lovshikvinnu/FieldSense/docs/images/pipeline_architecture.png

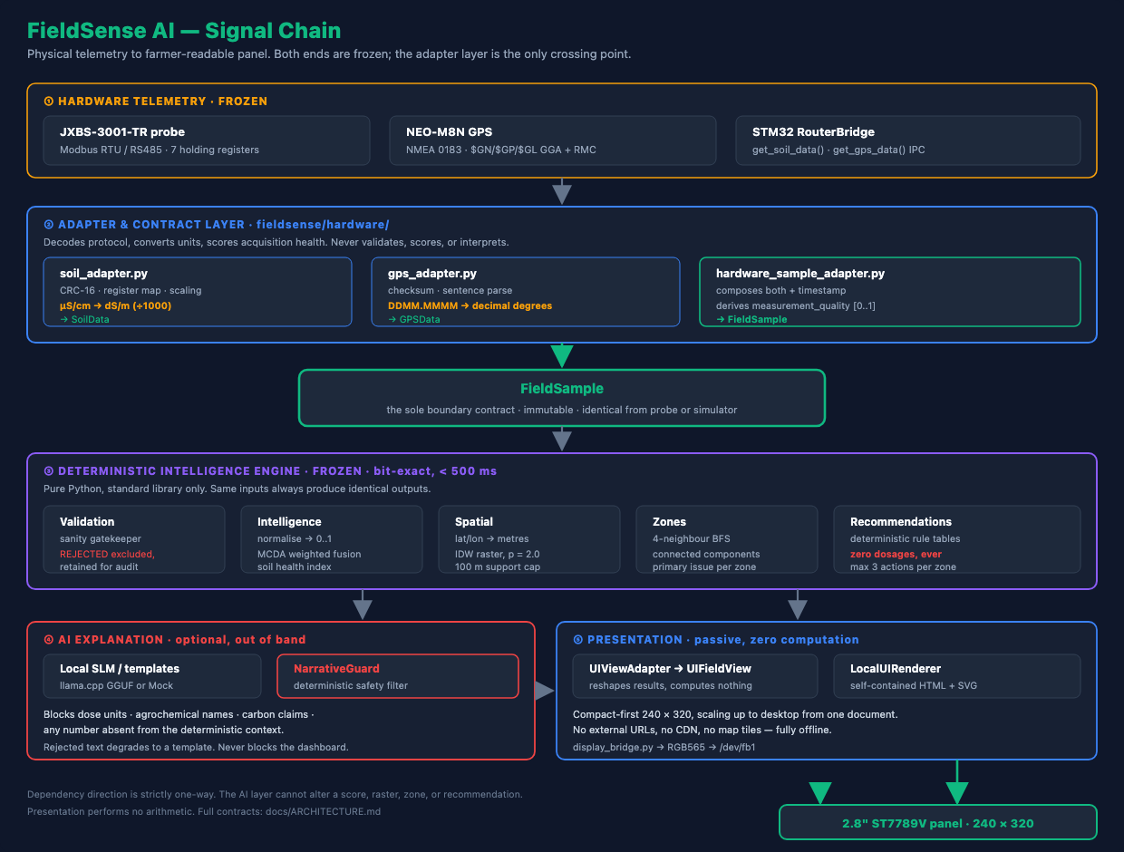
docs/images/pipeline_architecture.png
