lovshikvinnu/FieldSense/artifacts/field_test_map.html

FIELDSENSE AI

Offline Portable Edge-Intelligence Platform

OFFLINE MODE VIRTUAL

--%

MODERATE

●

Read More — AI Insights▸

Status & Diagnostics

Evidence LevelLIMITED

GPS Fix--

Sampling-- / --

Total Samples0

Valid0

Rejected0

Field Map

Tap a cell for details.

Management Zones

What Needs Attention

Plain Language Summary TEMPLATE ×
