lovshikvinnu/FieldSense/artifacts/field_test_panel.png

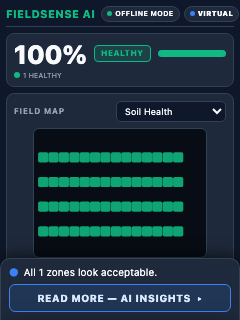
artifacts/field_test_panel.png
