lovshikvinnu/FieldSense/fieldsense/demo.py

"""FieldSense AI — Competition Demonstration Runner.

Executable via:
    python -m fieldsense.demo
"""

import os
from dataclasses import replace
from typing import Dict, Any

from fieldsense.testing.golden import GoldenDatasetRegistry
from fieldsense.intelligence import ValidationEngine, FieldIntelligenceEngine
from fieldsense.spatial import SpatialEngine, SpatialConfig
from fieldsense.zones import ZoneDetectionEngine
from fieldsense.recommendations import RecommendationEngine
from fieldsense.presentation import UIViewAdapter, LocalUIRenderer
from fieldsense.ai import AIAdapterFactory, build_explanation_context
from fieldsense.hardware.panel_renderer import write_panel_summary


def run_demo(
    output_path: str = "artifacts/fieldsense_competition_demo.html",
    scenario_name: str = "competition_demo_v1",
    enable_narrative: bool = True,
) -> Dict[str, Any]:
    """Execute complete 8-stage FieldSense pipeline demonstration and generate offline HTML dashboard.

    Args:
        output_path: Target path for HTML dashboard artifact output.
        scenario_name: Name of golden dataset scenario to load.
        enable_narrative: Attach an optional AI explanation narrative to the view.

    Returns:
        Dictionary containing demonstration summary metrics.
    """
    # 1. Load Competition Demonstration Golden Dataset
    scenario = GoldenDatasetRegistry.get_scenario(scenario_name)
    session = GoldenDatasetRegistry.load_session(scenario)
    total_samples = session.sample_count

    # 2. Validation Engine
    val_engine = ValidationEngine()
    eligible_samples = val_engine.get_session_eligible_samples(session)
    valid_samples = len(eligible_samples)
    rejected_samples = max(0, total_samples - valid_samples)

    # 3. Deterministic Intelligence Engine
    intel_engine = FieldIntelligenceEngine()
    intel_results = intel_engine.process_many(eligible_samples)

    # 4. Spatial Engine
    spatial_engine = SpatialEngine(config=SpatialConfig(grid_spacing_meters=10.0))
    spatial_result = spatial_engine.process(intel_results, eligible_samples)

    # 5. Zone Detection Engine
    zone_engine = ZoneDetectionEngine()
    zone_result = zone_engine.process(spatial_result)

    # 6. Recommendation Engine
    rec_engine = RecommendationEngine()
    rec_result = rec_engine.process(zone_result)

    # 7. UI View Adapter
    ui_adapter = UIViewAdapter()
    ui_view = ui_adapter.adapt(session, spatial_result, zone_result, rec_result)

    # 7b. Optional AI Explanation Layer.
    # Deliberately OUT OF BAND: it runs after the deterministic pipeline has
    # completed, never inside it. A real model backend costs tens of seconds on
    # edge hardware, far beyond the < 500 ms deterministic budget, so the
    # narrative must always be optional and always discardable.
    # The factory resolves to MockAIAdapter unless GGUF weights and a
    # llama.cpp binary are both present, so this upgrades automatically when a
    # model is installed and needs no code change.
    narrative = None
    if enable_narrative:
        ai_adapter = AIAdapterFactory.create_adapter()
        try:
            narrative = ai_adapter.explain(
                build_explanation_context(session, spatial_result, zone_result, rec_result)
            )
        finally:
            ai_adapter.shutdown()
        ui_view = replace(ui_view, narrative=narrative)

    # 8. Local HTML Renderer
    renderer = LocalUIRenderer()
    html_content = renderer.render_html(ui_view)

    # Ensure output directory exists
    os.makedirs(os.path.dirname(output_path), exist_ok=True)
    with open(output_path, "w", encoding="utf-8") as f:
        f.write(html_content)

    summary = {
        "dataset": scenario.name,
        "session_id": session.session_id,
        "total_samples": total_samples,
        "valid_samples": valid_samples,
        "rejected_samples": rejected_samples,
        "soil_health_score": ui_view.health_summary.score,
        "soil_health_status": ui_view.health_summary.status,
        "coverage_ratio": round(spatial_result.coverage.coverage_ratio * 100, 1),
        "zone_count": len(zone_result.zones),
        "recommendation_count": len(rec_result.recommendations),
        "output_path": output_path,
        "offline_mode": ui_view.system_status.offline_mode,
        "data_source": ui_view.system_status.data_source,
        "narrative_source": narrative.generated_by if narrative else "DISABLED",
        "narrative_status": narrative.generation_status.value if narrative else "DISABLED",
        "narrative_violations_blocked": len(narrative.guard_violations) if narrative else 0,
        "evidence_level": ui_view.health_summary.evidence_level,
        "field_name": ui_view.field.field_name,
        "soil_health_percent": round(ui_view.health_summary.score * 100.0),
        "provenance": "GOLDEN_DATASET",
    }

    # Panel summary for the browser-free display path. The 2.8" panel needs a
    # renderer that works with no Chromium installed, and that renderer reads
    # these numbers rather than recomputing them, so the panel can never
    # disagree with the dashboard. Failure to write it is non-fatal.
    # Beside the dashboard it describes, not at the module default. Writing to
    # the fixed artifacts/ path regardless of output_path meant any caller that
    # redirected the HTML - every test does - still rewrote the committed
    # summary, dirtying a tracked file nobody edited.
    summary["panel_summary_path"] = write_panel_summary(
        summary,
        os.path.join(os.path.dirname(output_path) or ".", "panel_summary.json"),
    )

    # Print clean terminal report
    print("\n==================================================")
    print("           FIELDSENSE AI — DEMO                   ")
    print("==================================================")
    print(f"Dataset:            {summary['dataset']}")
    print(f"Data Source:        {summary['data_source']} (Offline Mode: {summary['offline_mode']})")
    print(f"Samples:            {summary['total_samples']} Total | {summary['valid_samples']} Valid | {summary['rejected_samples']} Rejected")
    print(f"Overall Health:     {int(summary['soil_health_score'] * 100)}% [{summary['soil_health_status']}]")
    print(f"Coverage Ratio:     {summary['coverage_ratio']}%")
    print(f"Zones Detected:     {summary['zone_count']} Spatially Connected Management Zones")
    print(f"Recommendations:    {summary['recommendation_count']} Rule-Based Actions")
    print(f"Explanation Layer:  {summary['narrative_source']} [{summary['narrative_status']}] | Guard Blocks: {summary['narrative_violations_blocked']}")
    print(f"Dashboard Artifact: {summary['output_path']}")
    print("==================================================\n")

    return summary


if __name__ == "__main__":
    run_demo()
