lovshikvinnu/FieldSense/tests/test_landscape_panel.py

"""Hold the panel firmware to the landscape layout it claims.

The far side of this layout is firmware. A coordinate that runs off the bottom
of the screen, or an instruction string too long for the width it is drawn in,
is invisible until someone flashes a board and looks at it — and on the UNO Q a
flash-and-look cycle is about ninety seconds. These tests read the .ino files as
text so a clipped layout fails here instead.

Nothing is compiled or flashed. The sketches are parsed as source.
"""

import os
import re

import pytest

from fieldsense.field.panel import (
    ACTION_LINES,
    BUTTON_LABELS,
    RETRY_BUTTON_LABEL,
    RETRY_TEASER,
    TEASER_LINES,
)

REPO_ROOT = os.path.dirname(os.path.dirname(os.path.abspath(__file__)))
DEPLOYED = os.path.join(REPO_ROOT, "firmware", "fieldsense_unoq", "fieldsense_unoq.ino")
DISPLAY_ONLY = os.path.join(REPO_ROOT, "hardware", "tft-unoq", "dashboard", "dashboard.ino")
SKETCHES = (DEPLOYED, DISPLAY_ONLY)

# Adafruit_GFX's built-in font, which both sketches use.
CHAR_W = 6
CHAR_H = 8

# Must match the sketches' MARGIN and ACTION_H.
MARGIN = 6
ACTION_BOX_W = 320 - 2 * MARGIN
DRAW_CENTERED_PADDING = 8      # drawCentered() reserves this inside the box


def _read(path):
    if not os.path.exists(path):
        pytest.skip("sketch not present: {}".format(path))
    return open(path, encoding="utf-8", errors="replace").read()


#: Constants the layout expressions are allowed to reference. Resolved first so
#: a definition like `SOIL_COL_A = MARGIN + 8` can be evaluated here exactly as
#: the compiler would, rather than forcing every constant in the sketch to be a
#: bare literal purely so a test can read it.
_BASE_CONSTS = ("PANEL_W", "PANEL_H", "MARGIN")


def _const(source, name, _seen=None):
    """Read one layout constant, resolving simple arithmetic on other constants."""
    match = re.search(
        r"\b{}\s*=\s*([-+*/ 0-9A-Z_a-z]+?)\s*[;,]".format(re.escape(name)), source)
    assert match, "layout constant {} not found".format(name)
    expression = match.group(1).strip()

    seen = set(_seen or ())
    assert name not in seen, "circular layout constant: {}".format(name)
    seen.add(name)

    scope = {}
    for base in _BASE_CONSTS:
        if base != name and re.search(r"\b{}\b".format(base), expression):
            scope[base] = _const(source, base, seen)
    try:
        return int(eval(expression, {"__builtins__": {}}, scope))  # noqa: S307
    except Exception as exc:  # pragma: no cover - a malformed sketch constant
        raise AssertionError(
            "could not evaluate {} = {!r}: {}".format(name, expression, exc))


def _fit_size(text, width, max_size):
    """Mirror of the sketch's fitTextSize(): largest size that fits, floor 1."""
    if not text:
        return max_size
    for size in range(max_size, 1, -1):
        if len(text) * CHAR_W * size <= width:
            return size
    return 1


# ------------------------------------------------------- orientation


@pytest.mark.parametrize("path", SKETCHES)
def test_the_panel_boots_directly_into_landscape(path):
    """Not rotated later, not left to the host: landscape from setup().

    ST7789 rotations 1 and 3 are the same landscape surface 180 degrees apart -
    both report 320x240, so every coordinate in the sketch maps unchanged and
    either is a valid orientation for this unit. 0 and 2 are portrait and would
    invalidate the whole layout, which is what this actually guards.
    """
    source = _read(path)
    assert _const(source, "PANEL_ROTATION") in (1, 3), \
        "rotation must be landscape (1 or 3), not portrait"
    assert re.search(r"tft\.setRotation\(\s*PANEL_ROTATION\s*\)", source), \
        "setRotation must use PANEL_ROTATION so the constant cannot drift from the call"


@pytest.mark.parametrize("path", SKETCHES)
def test_the_background_is_black(path):
    """Every cleared region uses COL_BG, so this one constant is the background.

    It was a deep slate borrowed from the HTML dashboard - nearly black on a
    monitor, visibly grey on this panel in daylight, and every clear read as a
    grey flash rather than as background.
    """
    source = _read(path)
    match = re.search(r"\bCOL_BG\s*=\s*0x([0-9A-Fa-f]{4})", source)
    assert match, "COL_BG not found"
    assert int(match.group(1), 16) == 0x0000, \
        "COL_BG is 0x{}, not black".format(match.group(1))


@pytest.mark.parametrize("path", SKETCHES)
def test_no_full_screen_clear_outside_setup(path):
    """fillScreen on a periodic repaint is a visible wipe - there is no
    framebuffer between this sketch and the glass."""
    source = _read(path)
    body = source[source.index("static void renderValues"):]
    assert "fillScreen" not in body, \
        "renderValues (or something after it) clears the whole screen"


@pytest.mark.parametrize("path", SKETCHES)
def test_dynamic_regions_repaint_only_when_they_change(path):
    """The flicker fix. renderValues runs once a second so the age counter stays
    truthful, and almost nothing else on the panel changes in that second."""
    source = _read(path)
    assert "changedSince" in source, "the repaint-on-change guard is missing"
    body = source[source.index("static void renderValues"):]
    assert body.count("changedSince") >= 4, \
        "only {} dynamic regions are gated".format(body.count("changedSince"))


@pytest.mark.parametrize("path", SKETCHES)
def test_card_backgrounds_are_chrome_not_values(path):
    """Painting the card background every second is what wiped the card."""
    source = _read(path)
    assert "renderSoilChrome" in source and "renderResultChrome" in source, \
        "card background and labels should be separate from the value path"
    values = source[source.index("static void renderSoilCard"):
                    source.index("static void renderResultChrome")]
    assert "fillRoundRect" not in values, \
        "renderSoilCard still repaints its own card background"


@pytest.mark.parametrize("path", SKETCHES)
def test_the_drawing_surface_is_320_by_240(path):
    source = _read(path)
    assert _const(source, "PANEL_W") == 320
    assert _const(source, "PANEL_H") == 240


@pytest.mark.parametrize("path", SKETCHES)
def test_init_is_given_the_native_geometry_not_the_rotated_one(path):
    """init() takes the glass's real 240x320; setRotation does the rest.

    Passing the rotated size here is the classic version of this bug: the
    driver sets its address window from these numbers, so a 320x240 init
    produces a display that scrolls or wraps rather than one that is landscape.
    """
    source = _read(path)
    assert re.search(r"tft\.init\(\s*240\s*,\s*320\s*\)", source), \
        "tft.init() must be given the native 240x320 panel geometry"


@pytest.mark.parametrize("path", SKETCHES)
def test_no_portrait_geometry_survives_in_the_layout(path):
    """A leftover 240-wide assumption would hug everything to the left third."""
    source = _read(path)
    for name in ("HEADER_Y", "GPS_Y", "ACTION_Y", "SOIL_Y", "BAR_Y"):
        assert _const(source, name) < 240, \
            "{} is below a 240-tall landscape screen".format(name)


# ----------------------------------------------------------- fit


@pytest.mark.parametrize("path", SKETCHES)
def test_every_band_fits_inside_the_screen(path):
    """Bands must tile the height without running off the bottom edge."""
    source = _read(path)
    height = _const(source, "PANEL_H")
    bands = [
        (_const(source, "HEADER_Y"), _const(source, "HEADER_H")),
        (_const(source, "GPS_Y"), _const(source, "GPS_H")),
        (_const(source, "ACTION_Y"), _const(source, "ACTION_H")),
        (_const(source, "SOIL_Y"), _const(source, "SOIL_H")),
        (_const(source, "BAR_Y"), _const(source, "BAR_H")),
    ]
    for top, band_height in bands:
        assert top + band_height <= height, \
            "band at y={} height={} overruns the {}px screen".format(top, band_height, height)


@pytest.mark.parametrize("path", SKETCHES)
def test_the_bands_do_not_overlap(path):
    """Overlapping bands are how two values end up drawn on top of each other."""
    source = _read(path)
    bands = sorted([
        (_const(source, "HEADER_Y"), _const(source, "HEADER_H")),
        (_const(source, "GPS_Y"), _const(source, "GPS_H")),
        (_const(source, "ACTION_Y"), _const(source, "ACTION_H")),
        (_const(source, "SOIL_Y"), _const(source, "SOIL_H")),
        (_const(source, "BAR_Y"), _const(source, "BAR_H")),
    ])
    for (top, height), (next_top, _) in zip(bands, bands[1:]):
        assert top + height <= next_top, \
            "band at y={} (h={}) overlaps the band at y={}".format(top, height, next_top)


@pytest.mark.parametrize("path", SKETCHES)
def test_the_soil_columns_use_the_full_width(path):
    """Two columns are the whole reason for landscape; one column wastes it."""
    source = _read(path)
    col_a = _const(source, "SOIL_COL_A")
    assert col_a < 160, "the first soil column should start in the left half"
    assert re.search(r"SOIL_COL_B\s*=\s*PANEL_W\s*/\s*2", source), \
        "the second soil column should be derived from the panel width"


@pytest.mark.parametrize("path", SKETCHES)
def test_the_soil_rows_fit_inside_their_card(path):
    source = _read(path)
    row_h = _const(source, "SOIL_ROW_H")
    # Four label/value rows are drawn, the first at +6 from the card top.
    assert 6 + row_h * 3 + CHAR_H <= _const(source, "SOIL_H"), \
        "four soil rows do not fit inside SOIL_H"


# ------------------------------------------------ operator instructions


def test_every_operator_instruction_fits_the_landscape_width():
    """The host must not be able to send an instruction the panel would clip.

    drawCentered() truncates rather than overflowing, so a too-long string
    would not corrupt the layout - it would silently drop the end of the
    sentence, which on an instruction line is worse.
    """
    width = ACTION_BOX_W - DRAW_CENTERED_PADDING
    for state, template in ACTION_LINES.items():
        text = template.format(i=8, m=8)
        size = _fit_size(text, width, 3)
        assert len(text) * CHAR_W * size <= width, \
            "{}: {!r} clips even at text size 1".format(state.value, text)


def test_the_instructions_stay_large_enough_to_read_at_arms_length():
    """Every instruction should reach at least size 2, i.e. 16px tall glyphs."""
    width = ACTION_BOX_W - DRAW_CENTERED_PADDING
    for state, template in ACTION_LINES.items():
        text = template.format(i=8, m=8)
        assert _fit_size(text, width, 3) >= 2, \
            "{}: {!r} is too long to render above text size 1".format(state.value, text)


def test_the_headline_saved_message_gets_the_largest_size():
    """SAMPLE N SAVED is the confirmation an operator looks for from a distance."""
    text = ACTION_LINES[list(ACTION_LINES)[3]].format(i=1, m=5)
    assert _fit_size(text, ACTION_BOX_W - DRAW_CENTERED_PADDING, 3) == 3


# ------------------------------------------------------- both sketches


def test_both_sketches_share_the_same_layout_constants():
    """The bench panel and the field panel must not drift into two layouts."""
    deployed, display = _read(DEPLOYED), _read(DISPLAY_ONLY)
    for name in ("PANEL_W", "PANEL_H", "PANEL_ROTATION", "HEADER_Y", "HEADER_H",
                 "GPS_Y", "GPS_H", "ACTION_Y", "ACTION_H", "SOIL_Y", "SOIL_H",
                 "BAR_Y", "BAR_H", "MARGIN", "SOIL_ROW_H"):
        assert _const(deployed, name) == _const(display, name), \
            "{} differs between the two sketches".format(name)


def test_the_repo_layout_constants_match_the_ones_these_tests_assume():
    """Guard the constants this file hard-codes against a silent sketch edit."""
    source = _read(DEPLOYED)
    assert _const(source, "MARGIN") == MARGIN
    assert _const(source, "CHAR_W") == CHAR_W
    assert _const(source, "CHAR_H") == CHAR_H
    assert _const(source, "ACTION_H") >= CHAR_H * 3, \
        "the action band must be tall enough for size-3 text"


# ------------------------------------------------ visual-first UI elements


def _every_teaser():
    """Every guidance line the panel can display, expanded."""
    lines = [t.format(i=8, m=8) for t in TEASER_LINES.values()]
    lines.append(RETRY_TEASER.format(i=8, m=8))
    return lines


def _every_button():
    labels = [b for b in BUTTON_LABELS.values() if b]
    labels.append(RETRY_BUTTON_LABEL)
    return labels


def test_every_teaser_is_readable_at_arms_length():
    """Size 1 is 8 px tall and unreadable outdoors.

    'PROBE LOOSE - RE-SEAT IN SOIL' fitted only at size 1 - and it is the line
    an operator most needs to read without stopping to squint.
    """
    width = ACTION_BOX_W - DRAW_CENTERED_PADDING
    for text in _every_teaser():
        assert _fit_size(text, width, 3) >= 2, \
            "{!r} only renders at text size 1".format(text)


def test_every_button_label_renders_at_the_largest_size():
    """The single control has a whole bar to itself; it should use it."""
    width = ACTION_BOX_W - DRAW_CENTERED_PADDING
    for text in _every_button():
        assert _fit_size(text, width, 3) == 3, \
            "{!r} does not fit the action bar at size 3".format(text)


def test_teasers_are_one_line_and_short():
    """A 'teaser banner' that wraps is a paragraph again."""
    for text in _every_teaser():
        assert "\n" not in text
        assert len(text) <= 30, "{!r} is {} chars".format(text, len(text))


@pytest.mark.parametrize("path", SKETCHES)
def test_the_progress_strip_has_its_own_band(path):
    """The step bar must not share space with the header or the GPS line."""
    source = _read(path)
    prog_y, prog_h = _const(source, "PROG_Y"), _const(source, "PROG_H")
    assert prog_y >= _const(source, "HEADER_Y") + _const(source, "HEADER_H")
    assert prog_y + prog_h <= _const(source, "GPS_Y")


@pytest.mark.parametrize("path", SKETCHES)
def test_the_traffic_light_palette_is_the_specified_one(path):
    """Pure 0x07E0/0xF800 are driver primaries, not the product's colours."""
    source = _read(path)
    for name, value in (("COL_GOOD", 0x072E), ("COL_WARN", 0xFCC0),
                        ("COL_BAD", 0xFA8A)):
        match = re.search(r"\b{}\s*=\s*0x([0-9A-Fa-f]{{4}})".format(name), source)
        assert match, "{} not found".format(name)
        assert int(match.group(1), 16) == value, \
            "{} is 0x{} not 0x{:04X}".format(name, match.group(1), value)


@pytest.mark.parametrize("path", SKETCHES)
def test_the_panel_draws_a_tile_per_sample_and_per_zone(path):
    """Both grids read their length from the host string, not a fixed 5."""
    source = _read(path)
    assert "strlen(progressSegments)" in source, \
        "the progress strip should size itself from the host's string"
    assert "strlen(zoneStatuses)" in source, \
        "the zone map should size itself from the host's string"


def test_the_panel_rotation_matches_the_orientation_the_unit_was_read_in():
    """Rotation 3, established by holding the unit while it ran a rotation-3 sketch.

    An earlier version of this test asserted 1, on the argument that the board
    "ran the rotation-1 sketch continuously" and was upright. It did not: App
    Lab flashes its own copy of the sketch, and that copy was 209ae8a, which
    sets 3. The upright panel somebody looked at was a rotation-3 panel, so
    asserting 1 pinned the display upside down.

    Both values are landscape and the layout is identical either way, which is
    why this is worth pinning at all - nothing else in either sketch, and no
    other test, can tell the difference. It is also why a wrong value here
    survives every check except a human looking at the glass, so change it only
    on that evidence and say whose eyes.
    """
    assert _const(_read(DEPLOYED), "PANEL_ROTATION") == 3,         "the unit reads upright at rotation 3; 1 is the same surface upside down"
