lovshikvinnu/FieldSense/tests/test_field_node.py

"""The field node: triggers, one whole session, and the export it hands the pipeline.

The node is the only place hardware appears, so these tests substitute fakes for
the probe and the receiver and exercise everything else for real — the state
machine, the plausibility layer, the durable store, and the dataset written for
`run_spatial_test`. No board, no probe, no network.
"""

import json
import os
import threading
from datetime import datetime, timezone

import pytest

from fieldsense.domain.models import FieldSample
from fieldsense.domain.models.enums import SampleSource
from fieldsense.field.states import FieldState
from fieldsense.field_node import AutoTrigger, EnterTrigger, FieldNode, MCUTrigger
from fieldsense.hardware.gps.bridge_gps import UIEvent, parse_ui_event


# ------------------------------------------------------------- fakes


class FakeGPS:
    """Serves canned telemetry lines, the way the App Lab gateway would."""

    def __init__(self, lines):
        self.lines = list(lines)
        self.reads = 0

    def read_raw(self):
        self.reads += 1
        index = min(self.reads - 1, len(self.lines) - 1)
        return self.lines[index]


class FakeAdapter:
    """A probe and receiver that produce exactly the readings a test asks for."""

    def __init__(self, readings, gps_lines=None):
        self.readings = list(readings)
        self.index = 0
        self.initialized = False
        self.shutdown_called = False
        self.gps_adapter = FakeGPS(gps_lines or ["NO_FIX,0.0,0.0,Sats:0,HDOP:99.9,UI:0,TP:1,TZ:0"])
        self.last_acquisition_meta = {}

    def initialize(self):
        self.initialized = True

    def shutdown(self):
        self.shutdown_called = True

    def acquire_sample(self):
        reading = self.readings[min(self.index, len(self.readings) - 1)]
        self.index += 1
        self.last_acquisition_meta = {
            "gps_fix_valid": reading.get("fix_valid", True),
            "gps_quality": {"satellites": reading.get("satellites", 10),
                            "hdop": reading.get("hdop", 0.96)},
            "sensor_meta": {},
            "measurement_quality": reading.get("quality", 0.95),
        }
        return FieldSample(
            sample_id="HW-SMP-{:03d}".format(self.index),
            timestamp=datetime.now(timezone.utc),
            latitude=reading.get("lat", 17.5697),
            longitude=reading.get("lon", 78.4247),
            nitrogen=reading.get("nitrogen", 48.0),
            phosphorus=reading.get("phosphorus", 22.0),
            potassium=reading.get("potassium", 133.0),
            ph=reading.get("ph", 6.6),
            ec=reading.get("ec", 0.42),
            moisture=reading.get("moisture", 31.2),
            temperature=reading.get("temperature", 26.4),
            measurement_quality=reading.get("quality", 0.95),
            source=SampleSource.HARDWARE,
        )


def build_node(tmp_path, adapter, samples=3, **kwargs):
    """A node wired to `adapter`, writing everything under tmp_path."""
    node = FieldNode(
        planned_samples=samples,
        trigger="auto",
        panel_endpoint=None,
        session_root=str(tmp_path / "sessions"),
        output_dir=str(tmp_path / "artifacts"),
        dataset_path=str(tmp_path / "dataset.json"),
        settle_seconds=0.0,
        dwell_seconds=0.0,
        auto_delay=0.0,
        **kwargs,
    )
    node.adapter = adapter
    node.open_hardware = lambda: adapter.initialize()
    node.show = lambda extra=None: None          # no panel in a unit test
    # No background narrative either: it would re-run the whole pipeline in a
    # daemon thread and outlive the tmp_path it writes into. The tests that
    # care about it call FieldNode.start_narrative directly.
    node.start_narrative = lambda dataset: None
    return node


# ----------------------------------------------------------- triggers


def test_the_mcu_trigger_fires_on_a_counter_that_moved():
    gps = FakeGPS([
        "FIX_OK,1734.18N,07825.47E,Sats:10,HDOP:0.96,UI:4,TP:1,TZ:0",
        "FIX_OK,1734.18N,07825.47E,Sats:10,HDOP:0.96,UI:5,TP:1,TZ:1900",
    ])
    trigger = MCUTrigger(gps.read_raw, poll_seconds=0.0)
    trigger.sync()
    assert trigger.wait_for_press(timeout=2.0)


def test_the_mcu_trigger_ignores_a_counter_that_has_not_moved():
    gps = FakeGPS(["FIX_OK,1734.18N,07825.47E,Sats:10,HDOP:0.96,UI:4,TP:1,TZ:0"])
    trigger = MCUTrigger(gps.read_raw, poll_seconds=0.0)
    trigger.sync()
    assert not trigger.wait_for_press(timeout=0.2)


def test_syncing_adopts_a_press_that_happened_before_the_session_started():
    """Otherwise a press during boot fires sample 1 the instant the node arms."""
    gps = FakeGPS(["FIX_OK,1734.18N,07825.47E,Sats:10,HDOP:0.96,UI:7,TP:1,TZ:0"])
    trigger = MCUTrigger(gps.read_raw, poll_seconds=0.0)
    trigger.sync()
    assert trigger.last_count == 7
    assert not trigger.wait_for_press(timeout=0.2)


def test_an_mcu_reset_does_not_fire_a_burst_of_triggers():
    """A reflash restarts the counter at zero. That is not thirty presses."""
    gps = FakeGPS([
        "FIX_OK,1734.18N,07825.47E,Sats:10,HDOP:0.96,UI:30,TP:1,TZ:0",
        "FIX_OK,1734.18N,07825.47E,Sats:10,HDOP:0.96,UI:0,TP:1,TZ:0",
    ])
    trigger = MCUTrigger(gps.read_raw, poll_seconds=0.0)
    trigger.sync()
    assert not trigger.wait_for_press(timeout=0.2)
    assert trigger.last_count == 0


def test_firmware_without_the_control_is_distinguishable_from_no_press():
    old = parse_ui_event("FIX_OK,1734.18N,07825.47E,Sats:10,HDOP:0.96")
    assert not old.reported
    assert UIEvent(press_count=0).reported


def test_the_trigger_reports_a_panel_that_has_not_been_touched():
    gps = FakeGPS(["FIX_OK,1734.18N,07825.47E,Sats:10,HDOP:0.96,UI:0,TP:0,SA:0,TZ:0"])
    trigger = MCUTrigger(gps.read_raw, poll_seconds=0.0)
    trigger.sync()
    assert "no touch detected yet" in trigger.describe()


def test_the_trigger_distinguishes_pen_detect_from_working_coordinates():
    """The assembled unit pen-detects but its controller is silent over SPI.

    Conflating those two facts is what previously made the boot log claim touch
    was absent while it was in fact driving the workflow.
    """
    pen_only = FakeGPS(["FIX_OK,1734.18N,07825.47E,Sats:10,HDOP:0.96,UI:3,TP:1,SA:0,TZ:0"])
    trigger = MCUTrigger(pen_only.read_raw, poll_seconds=0.0)
    trigger.sync()
    assert "PEN-DETECT ONLY" in trigger.describe()

    full = FakeGPS(["FIX_OK,1734.18N,07825.47E,Sats:10,HDOP:0.96,UI:3,TP:1,SA:1,TZ:900"])
    trigger = MCUTrigger(full.read_raw, poll_seconds=0.0)
    trigger.sync()
    assert "with coordinates" in trigger.describe()


def test_the_auto_trigger_says_it_is_not_an_operator():
    assert "REHEARSAL" in AutoTrigger(0.0).describe()


# -------------------------------------------------------- whole session


def test_a_three_sample_walk_stores_three_separate_samples(tmp_path):
    adapter = FakeAdapter([
        {"lat": 17.5697, "moisture": 31.2},
        {"lat": 17.5701, "moisture": 28.4},
        {"lat": 17.5705, "moisture": 25.9},
    ])
    node = build_node(tmp_path, adapter, samples=3)
    assert node.run() == 0

    records = node.session.store.records()
    assert [r["sample_index"] for r in records] == [1, 2, 3]
    assert [r["quality"] for r in records] == ["VALID"] * 3
    assert len({r["gps"]["latitude"] for r in records}) == 3
    assert node.session.distinct_location_count() == 3
    assert node.session.state is FieldState.RESULT
    assert adapter.shutdown_called


def test_the_exported_dataset_is_the_schema_the_frozen_pipeline_reads(tmp_path):
    adapter = FakeAdapter([
        {"lat": 17.5697 + i * 0.0004, "moisture": 31.2 - i} for i in range(3)])
    node = build_node(tmp_path, adapter, samples=3)
    node.run()

    entries = json.load(open(str(tmp_path / "dataset.json")))
    assert len(entries) == 3
    for entry in entries:
        assert set(entry) == {"field_sample", "field_intelligence_result",
                              "provenance", "acquired_at"}
        assert json.loads(entry["field_sample"])["sample_id"].startswith("HW-SMP-")
        assert entry["provenance"] == "LIVE_HARDWARE"


def test_samples_taken_in_air_never_reach_the_map(tmp_path):
    """They are stored, they are marked, and they are not interpolated."""
    air = {"moisture": 0.0, "ec": 0.0, "nitrogen": 0.0,
           "phosphorus": 0.0, "potassium": 0.0}
    adapter = FakeAdapter([dict(air, lat=17.5697 + i * 0.0004) for i in range(3)])
    node = build_node(tmp_path, adapter, samples=3)
    node.run()

    records = node.session.store.records()
    assert records, "the evidence must still be stored"
    assert all(r["quality"] == "SUSPICIOUS" for r in records)
    assert node.session.map_eligible_records() == []
    assert not os.path.exists(str(tmp_path / "dataset.json"))


def test_a_session_short_of_usable_samples_is_reported_not_processed(tmp_path):
    adapter = FakeAdapter([
        {"lat": 17.5697, "moisture": 31.2},
        {"moisture": 0.0, "ec": 0.0, "nitrogen": 0.0, "phosphorus": 0.0,
         "potassium": 0.0, "lat": 17.5701},
        {"moisture": 0.0, "ec": 0.0, "nitrogen": 0.0, "phosphorus": 0.0,
         "potassium": 0.0, "lat": 17.5705},
    ])
    node = build_node(tmp_path, adapter, samples=3)
    node.run()
    outcome = node.process()
    assert outcome["processed"] is False
    assert "usable for a map" in outcome["reason"]


def test_a_session_survives_being_resumed_after_a_power_cut(tmp_path):
    """Sample 1 and 2 are on disk; the resumed run must start at sample 3."""
    first = FakeAdapter([{"lat": 17.5697, "moisture": 31.2},
                         {"lat": 17.5701, "moisture": 28.4}])
    node = build_node(tmp_path, first, samples=2)
    node.run()
    session_id = node.session.store.session_id

    second = FakeAdapter([{"lat": 17.5705, "moisture": 25.9}])
    resumed = build_node(tmp_path, second, samples=3, resume=session_id)
    resumed.run()

    assert resumed.session.store.session_id == session_id
    indices = [r["sample_index"] for r in resumed.session.store.records()]
    assert indices == [1, 2, 3]


def test_every_sample_records_the_position_it_was_actually_taken_at(tmp_path):
    adapter = FakeAdapter([
        {"lat": 17.5697, "lon": 78.4247, "hdop": 0.9, "satellites": 11},
        {"lat": 17.5701, "lon": 78.4251, "hdop": 1.4, "satellites": 9},
    ])
    node = build_node(tmp_path, adapter, samples=2)
    node.run()
    gps = [r["gps"] for r in node.session.store.records()]
    assert gps[0]["latitude"] == 17.5697 and gps[0]["hdop"] == 0.9
    assert gps[1]["latitude"] == 17.5701 and gps[1]["satellites"] == 9


def test_a_probe_that_raises_is_retried_rather_than_ending_the_session(tmp_path):
    class Flaky(FakeAdapter):
        def acquire_sample(self):
            if self.index == 1:
                self.index += 1
                raise OSError("RS485 read timed out")
            return super().acquire_sample()

    adapter = Flaky([
        {"lat": 17.5697 + i * 0.0004, "moisture": 31.2 - i} for i in range(4)])
    node = build_node(tmp_path, adapter, samples=2)
    assert node.run() == 0
    assert node.session.stored_count == 2


def test_nothing_in_the_node_opens_an_outbound_network_connection(tmp_path):
    """The unit must run with the radios off. The panel and gateway are local."""
    import socket

    opened = []
    original = socket.socket.connect

    def watched(self, address):
        opened.append(address)
        return original(self, address)

    socket.socket.connect = watched
    try:
        adapter = FakeAdapter([
            {"lat": 17.5697 + i * 0.0004, "moisture": 31.2 - i} for i in range(3)])
        node = build_node(tmp_path, adapter, samples=3)
        node.run()
    finally:
        socket.socket.connect = original

    remote = [a for a in opened
              if isinstance(a, tuple) and a[0] not in ("127.0.0.1", "localhost", "::1")]
    assert not remote, "the node reached off-board: {}".format(remote)


# ------------------------------------------------- the board's own buttons


def _input_event(code, value, kind=1):
    """One struct input_event, as the kernel would write it."""
    import struct

    from fieldsense.field_node import INPUT_EVENT_FORMAT

    return struct.pack(INPUT_EVENT_FORMAT, 0, 0, kind, code, value)


def _fake_evdev(tmp_path, payload):
    """A file standing in for /dev/input/by-path/platform-gpio-keys-event."""
    path = str(tmp_path / "gpio-keys-event")
    with open(path, "wb") as handle:
        handle.write(payload)
    return path


def test_a_volume_key_press_is_a_start_press(tmp_path):
    from fieldsense.field_node import GPIO_KEY_CODES, ButtonTrigger

    path = _fake_evdev(tmp_path, _input_event(GPIO_KEY_CODES[0], 1))
    trigger = ButtonTrigger(device_path=path)
    assert trigger.available()
    assert trigger.poll()
    trigger.close()


def test_either_volume_key_starts_a_sample(tmp_path):
    """One action, two identical-feeling buttons. Remembering which is a trap."""
    from fieldsense.field_node import GPIO_KEY_CODES, ButtonTrigger

    for code in GPIO_KEY_CODES:
        trigger = ButtonTrigger(device_path=_fake_evdev(tmp_path, _input_event(code, 1)))
        assert trigger.poll(), "key {} did not trigger".format(code)
        trigger.close()


def test_a_key_release_is_not_a_press(tmp_path):
    from fieldsense.field_node import GPIO_KEY_CODES, ButtonTrigger

    trigger = ButtonTrigger(
        device_path=_fake_evdev(tmp_path, _input_event(GPIO_KEY_CODES[0], 0)))
    assert not trigger.poll()
    trigger.close()


def test_autorepeat_is_not_a_second_press(tmp_path):
    """A held button must take one sample, not one per repeat interval."""
    from fieldsense.field_node import GPIO_KEY_CODES, ButtonTrigger

    trigger = ButtonTrigger(
        device_path=_fake_evdev(tmp_path, _input_event(GPIO_KEY_CODES[0], 2)))
    assert not trigger.poll()
    trigger.close()


def test_a_non_key_event_is_ignored(tmp_path):
    """EV_SYN separators share the stream and must not read as presses."""
    from fieldsense.field_node import GPIO_KEY_CODES, ButtonTrigger

    trigger = ButtonTrigger(
        device_path=_fake_evdev(tmp_path, _input_event(GPIO_KEY_CODES[0], 1, kind=0)))
    assert not trigger.poll()
    trigger.close()


def test_syncing_discards_presses_queued_before_the_session_armed(tmp_path):
    from fieldsense.field_node import GPIO_KEY_CODES, ButtonTrigger

    payload = _input_event(GPIO_KEY_CODES[0], 1) * 3
    trigger = ButtonTrigger(device_path=_fake_evdev(tmp_path, payload))
    trigger.sync()
    assert not trigger.poll()
    trigger.close()


def test_a_missing_input_device_is_reported_not_crashed():
    """A unit with no readable evdev node must say so, not raise at boot."""
    from fieldsense.field_node import ButtonTrigger

    trigger = ButtonTrigger(device_path="/nonexistent/gpio-keys")
    assert not trigger.available()
    assert "UNAVAILABLE" in trigger.describe()
    assert not trigger.poll()


def test_the_composite_trigger_fires_on_whichever_control_was_used(tmp_path):
    from fieldsense.field_node import GPIO_KEY_CODES, ButtonTrigger, CompositeTrigger

    gps = FakeGPS(["FIX_OK,1734.18N,07825.47E,Sats:10,HDOP:0.96,UI:0,TP:0,TZ:0"])
    button = ButtonTrigger(device_path=_fake_evdev(tmp_path, _input_event(GPIO_KEY_CODES[1], 1)))
    mcu = MCUTrigger(gps.read_raw, poll_seconds=0.0)
    mcu.sync()

    composite = CompositeTrigger([button, mcu])
    assert composite.poll()
    composite.close()


def test_the_composite_trigger_drops_unavailable_controls(tmp_path):
    """A unit with no buttons wired must still run on whatever it does have."""
    from fieldsense.field_node import ButtonTrigger, CompositeTrigger

    gps = FakeGPS(["FIX_OK,1734.18N,07825.47E,Sats:10,HDOP:0.96,UI:0,TP:0,TZ:0"])
    composite = CompositeTrigger([
        ButtonTrigger(device_path="/nonexistent/gpio-keys"),
        MCUTrigger(gps.read_raw, poll_seconds=0.0),
    ])
    assert composite.available()
    assert [s.name for s in composite.sources] == ["mcu"]


def test_a_unit_with_no_control_at_all_says_so(tmp_path):
    from fieldsense.field_node import ButtonTrigger, CompositeTrigger

    composite = CompositeTrigger([ButtonTrigger(device_path="/nonexistent/gpio-keys")])
    assert not composite.available()
    assert "NO OPERATOR CONTROL" in composite.describe()


# ------------------------------------- duplicate presses and the new-run gate


class CountingTrigger(AutoTrigger):
    """An auto trigger that records how often it was synced and polled."""

    def __init__(self, presses_available=99):
        super().__init__(0.0)
        self.syncs = 0
        self.presses_available = presses_available
        self.presses_taken = 0

    def sync(self):
        self.syncs += 1

    def wait_for_press(self, timeout=None):
        if self.presses_taken >= self.presses_available:
            return False
        self.presses_taken += 1
        return True


def test_presses_made_while_the_device_was_busy_are_discarded(tmp_path):
    """A tap during MEASURING must not fire the next sample instantly.

    The press counter is monotonic and only diffed inside wait_for_press, so
    without a resync an impatient second tap sits in the counter and consumes
    the next wait before the operator has moved or seen READY.
    """
    adapter = FakeAdapter([
        {"lat": 17.5697 + i * 0.0004, "moisture": 31.2 - i} for i in range(3)])
    node = build_node(tmp_path, adapter, samples=3)
    trigger = CountingTrigger()
    node.build_trigger = lambda: trigger
    node.run()

    # One sync before each armed wait, plus one before the result hold.
    assert trigger.syncs >= 3, "the trigger was not resynced between samples"


def test_the_result_screen_waits_for_the_operator(tmp_path):
    """--loop would otherwise replace the result with READY seconds later."""
    adapter = FakeAdapter([
        {"lat": 17.5697 + i * 0.0004, "moisture": 31.2 - i} for i in range(3)])
    node = build_node(tmp_path, adapter, samples=3)
    trigger = CountingTrigger()
    node.build_trigger = lambda: trigger
    node.run()

    assert node.session.state is FieldState.RESULT
    # The samples plus the new-run tap.
    assert trigger.presses_taken >= 4


def test_the_new_run_wait_is_bounded_for_an_unattended_unit(tmp_path):
    """A unit left switched on must recycle rather than hold forever."""
    from fieldsense.field_node import RESULT_HOLD_SECONDS

    assert 0 < RESULT_HOLD_SECONDS <= 3600

    adapter = FakeAdapter([
        {"lat": 17.5697 + i * 0.0004, "moisture": 31.2 - i} for i in range(3)])
    node = build_node(tmp_path, adapter, samples=3)
    trigger = CountingTrigger(presses_available=3)   # no press for the result
    node.build_trigger = lambda: trigger
    assert node.run() == 0
    assert node.await_new_run() is False


def test_await_new_run_does_nothing_outside_the_result_state(tmp_path):
    adapter = FakeAdapter([{"lat": 17.5697, "moisture": 31.2}])
    node = build_node(tmp_path, adapter, samples=1)
    node.session = None
    assert node.await_new_run() is False


def test_a_session_that_could_not_be_processed_also_holds_the_screen(tmp_path):
    """The reason is the most useful thing a failed run has to show.

    Holding only on RESULT meant "0 of 5 samples are usable" appeared and was
    replaced by READY within seconds, so an operator learned nothing from a
    walk that went wrong.
    """
    air = {"moisture": 0.0, "ec": 0.0, "nitrogen": 0.0,
           "phosphorus": 0.0, "potassium": 0.0}
    adapter = FakeAdapter([dict(air, lat=17.5697 + i * 0.0004) for i in range(3)])
    node = build_node(tmp_path, adapter, samples=3)
    trigger = CountingTrigger()
    node.build_trigger = lambda: trigger
    node.run()

    assert node.session.state is FieldState.ERROR
    assert node.session.map_eligible_records() == []
    # The hold ran: it accepted a press rather than returning immediately.
    assert node.await_new_run() is True


def test_the_result_overlay_sends_the_zone_letters_to_the_panel(tmp_path):
    """The zone map read NO ZONES on every finished run.

    `run_spatial_test` writes one status letter per zone into
    panel_summary.json, the panel record already reserves field `u` for them,
    and the firmware already parses `u` into the string `renderZoneGrid` draws
    from. Only the overlay that folds the finished pipeline onto the result
    screen never forwarded the key, so the sketch was never given a value at
    all - and because it keeps the last value it was given, the grid took its
    empty-string branch and drew NO ZONES however many zones had been found.

    A live session on the board found one zone, wrote "G" to panel_summary.json,
    and still showed NO ZONES on the glass. That is the case this pins.
    """
    from fieldsense.hardware.panel_renderer import build_panel_record

    adapter = FakeAdapter([{"lat": 17.5697, "moisture": 31.2}])
    node = build_node(tmp_path, adapter, samples=1)
    os.makedirs(node.output_dir, exist_ok=True)
    with open(os.path.join(node.output_dir, "panel_summary.json"), "w",
              encoding="utf-8") as handle:
        json.dump({"soil_health_status": "HEALTHY", "soil_health_score": 0.73,
                   "evidence_level": "LIMITED", "zone_statuses": "GAR"}, handle)

    overlay = node._result_overlay({"zones": 3, "recommendations": 2},
                                   {"distinct_locations": 5})

    assert overlay["zone_statuses"] == "GAR"
    # The zone count was already being sent; it is the letters the grid draws.
    assert overlay["zone_count"] == 3
    # And the letters survive into the record the MCU actually parses.
    assert "u=GAR" in build_panel_record(overlay).decode("ascii").strip().split("|")


def test_a_run_with_no_zone_letters_omits_the_field_rather_than_blanking_it(tmp_path):
    """Absent has to stay absent, because the sketch keeps its last value.

    Sending an empty `u` would wipe a zone grid that is still the truth, which
    is the same reason build_panel_record drops None keys instead of writing
    them empty.
    """
    adapter = FakeAdapter([{"lat": 17.5697, "moisture": 31.2}])
    node = build_node(tmp_path, adapter, samples=1)   # no panel_summary.json

    overlay = node._result_overlay({"zones": 0, "recommendations": 0},
                                   {"distinct_locations": 1})

    assert "zone_statuses" not in overlay


# ------------------------------------------------- non-blocking narrative


def test_the_map_reaches_the_panel_without_waiting_for_the_narrative(tmp_path, monkeypatch):
    """The operator used to stand in a field for two minutes watching PROCESSING.

    Every deterministic result - grid, zones, health score - is finished about a
    second after the last sample. The local SLM then took 124,957 ms on top of
    it, and on the run that prompted this the fidelity guard rejected what it
    produced anyway. The result screen must not be behind that.
    """
    import run_spatial_test as rst

    seen = {}

    def fake_pipeline(**kwargs):
        seen.update(kwargs)
        return {"zones": 1, "recommendations": 2, "samples": 3}

    monkeypatch.setattr(rst, "run_spatial_test", fake_pipeline)

    adapter = FakeAdapter([
        {"lat": 17.5697 + i * 0.0004, "moisture": 31.2 - i} for i in range(3)])
    node = build_node(tmp_path, adapter, samples=3)
    shown = []
    node.show = lambda extra=None: shown.append(extra or {})
    node.run()

    assert seen["with_narrative"] is False
    assert shown, "the result screen was never pushed"


def test_the_narrative_runs_in_the_background_and_reports_when_it_lands(tmp_path, monkeypatch):
    """start_narrative must return while the SLM is still working."""
    import run_spatial_test as rst

    release = threading.Event()
    monkeypatch.setattr(rst, "run_spatial_test", lambda **k: release.wait(10))

    node = build_node(tmp_path, FakeAdapter([{"lat": 17.5697}]), samples=1)
    thread = FieldNode.start_narrative(node, "dataset.json")   # bypass the stub

    assert thread.is_alive()                       # returned before the SLM did
    assert node.narrative_status == "WORKING"
    release.set()
    thread.join(15)
    assert not thread.is_alive()
    assert node.narrative_status == "READY"


def test_a_narrative_that_fails_says_so_instead_of_claiming_it_is_ready(tmp_path, monkeypatch):
    import run_spatial_test as rst

    def boom(**kwargs):
        raise RuntimeError("no weights")

    monkeypatch.setattr(rst, "run_spatial_test", boom)

    node = build_node(tmp_path, FakeAdapter([{"lat": 17.5697}]), samples=1)
    FieldNode.start_narrative(node, "dataset.json").join(15)

    assert node.narrative_status == "UNAVAILABLE"


def test_the_result_record_still_fits_the_firmware_line_buffer():
    """fieldsense_unoq.ino reads into lineBuf[256] and DROPS AN OVERLONG LINE WHOLE.

    Not truncates - drops, silently, with no error anywhere. A field added to
    the result record that pushes it past 255 bytes does not lose that field,
    it loses the entire screen update. The record measured 200 bytes before
    ai_status, so the headroom is real but small; this is the test that fails
    before the panel goes quiet in a field.
    """
    from fieldsense.hardware.panel_renderer import build_panel_record

    record = build_panel_record({
        "field_name": "20260904T100837Z", "workflow_state": "RESULT",
        "sample_index": 5, "planned_samples": 5,
        "action_line": "FIELD RESULT READY", "button_label": "HOLD FOR NEW RUN",
        "progress_segments": "VVVVV", "total_samples": 5, "valid_samples": 5,
        "rejected_samples": 0, "distinct_locations": 5, "offline_mode": True,
        "sample_quality": "VALID", "moisture": 0.0, "ph": 7.4, "ec": 0.866,
        "nitrogen": 61.0, "phosphorus": 86.0, "potassium": 173.0,
        "soil_health_status": "HEALTHY", "soil_health_score": 0.73,
        "zone_count": 1, "recommendation_count": 2, "evidence_level": "LIMITED",
        "zone_statuses": "G",
    })
    assert len(record) < 256, "record is {} bytes; the MCU drops it".format(len(record))
