lovshikvinnu/FieldSense/(commit log)

2026-08-23 Add display bridge, ST7789V framebuffer launcher, and viewport tests
2026-08-23 Final submission polish: hero UI preview, Soil to Decision workflow, and clean schematics
2026-08-23 Complete live hardware collector, provenance guard, and 7-stage spatial rendering bridge
2026-08-23 Track spatial test bridge script
2026-08-24 Feat: Complete Path B MCU Frame Bridge (C++ sketch + Python serial transport)
2026-08-24 Split TFT_UNOQ sketches into per-sketch directories
    arduino-cli merges every .ino in a sketch folder into one translation unit,
    so sketch.ino (touch demo, needs XPT2046) and sketch_frame_receiver.ino
    could never compile as siblings - the frame receiver build pulled in the
    demo's includes and its duplicate setup()/loop().
    Each sketch now lives in a directory named after its main file, which is
    also what arduino-cli requires:
    frame_receiver/frame_receiver.ino (was sketch_frame_receiver.ino)
    touch_demo/touch_demo.ino (was sketch.ino)
    Comment and docstring references in display_bridge.py and
    test_mcu_frame_bridge.py updated to the new paths.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
2026-08-24 Record verified UNO Q build for the frame receiver
    frame_receiver.ino builds clean for arduino:zephyr:unoq (12% flash, 15% RAM)
    once three environment prerequisites are met. Documents all three in
    TFT_UNOQ_INTEGRATION.md so they survive a fresh board image: one sketch per
    directory, Arduino_RouterBridge installed, and the display library pinned to
    1.10.4 to avoid the ST7796S/MOSI macro collision added in 1.11.0.
    Also corrects the MAX_CHUNK comment, which cited the U585's 786 KB of SRAM as
    headroom. The build output shows Zephyr gives this image 256 KB, of which the
    sketch already uses 40968 bytes - 786432 is the flash ceiling, not the RAM one.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
    [frame_receiver.ino]
2026-08-24 Start the bridge explicitly and report link state on the panel
    Adds Arduino_RouterBridge.h and an explicit Bridge.begin(), plus a bounded
    wait for Monitor, and reports the outcome on the TFT.
    Note what this does NOT claim: Monitor::begin() already starts the bridge
    when it is not up (monitor.h), so the previously missing Bridge.begin() was
    not the reason the host saw no ACK. The explicit call is kept only because it
    separates a dead RPC transport from an unattached monitor client - two states
    that are indistinguishable from the panel otherwise.
    On this board Serial is an alias of Monitor, a BridgeMonitor Stream over the
    MsgPack-RPC pair mon/read + mon/write, re-exposed Linux-side by arduin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
    [frame_receiver.ino]
2026-08-24 Reach the UNO Q panel over the router monitor proxy, not a serial node
    Verified on hardware: the sketch ACKs a frame header sent to 127.0.0.1:7500.
    There is no serial device the host can open to reach the STM32 on this board.
    Serial in a UNO Q sketch is Arduino_RouterBridge's Monitor stream over
    MsgPack-RPC, and arduino-router holds /dev/ttyHS1 exclusively while
    re-exposing that stream as a loopback TCP listener. /dev/ttyGS0 - the previous
    default - does not exist here, and /dev/ttyUSB0 is the FTDI behind the MAX485,
    i.e. the soil sensor's Modbus bus, which a frame would jam.
    Adds TcpTransport against the existing SensorTransport contract, so
    stream_frame_to_mcu() is unchanged: it takes an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
    [tcp_socket.py, test_mcu_frame_bridge.py, test_standalone_deployment.py]
2026-08-24 Report which chunk aborted and why, and size timeouts for RPC
    The panel is the only console this board has, and a single red banner
    conflated four different failures: payload timeout, CRC-byte timeout, CRC
    mismatch, and whole-frame timeout. Chunk 1 dying is a different bug from
    chunk 37 dying. Every wrong guess costs a reflash, because the RouterBridge
    monitor link currently accepts only one client per boot, so each attempt has
    to buy as much information as possible. The banner now names the failure and
    the chunk index out of the expected count, with bytes transferred and elapsed
    ms on the line below.
    Timeouts were written against a UART assumption. Every read here is a
    mon/read RPC round t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
    [frame_receiver.ino]
2026-08-24 Take the SPI bus per chunk, not per frame - it was starving the RPC thread
    The receiver wrapped the whole frame in one startWrite()/endWrite() pair and
    set the address window once. On the UNO Q that deadlocks the transfer:
    SPI.beginTransaction() takes the bus mutex, and the Arduino_RouterBridge RPC
    serving Serial runs on a separate Zephyr thread, so holding the transaction
    starves the thread that would deliver mon/read data. Every read after
    startWrite() waits for bytes that cannot arrive.
    The evidence was unambiguous once the panel reported chunk-level detail: the
    12-byte header ACKed normally, then chunk 1 returned 0 of 153600 bytes after
    an 8 s wait. Dropping chunks from 4096 to 256 chan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
2026-08-24 Add frame protocol v2: stream the frame, one status byte at the end
    The per-chunk ACK cannot work on the UNO Q, and monitor.h explains why.
    Serial there is Arduino_RouterBridge's Monitor: reads go through
    bridge->call(MON_READ_METHOD) inside _read(), writes through
    bridge->call(MON_WRITE_METHOD), on the same RPC channel. An ACK mid-frame
    breaks the next read - and the library hides it, because the
    `_connected = false` line in _read()'s error path is commented out. A failed
    mon/read stores nothing, raises nothing, and available() returns 0 forever.
    That matches every measurement: the 12-byte header ACKs, then chunk 1 reports
    0 of 153600 bytes after an 8 s wait, identically at 4096, 3840 and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
    [frame_receiver.ino, test_mcu_frame_bridge.py]
2026-08-24 Add a link probe to measure the UNO Q Monitor link directly
    Three theories about the stalled frame transfer have now died on hardware, one
    reflash each: the 512-byte RingBufferN (256-byte chunks failed identically),
    the SPI bus mutex starving the RPC thread (per-chunk transactions changed
    nothing), and a mid-frame write breaking the next mon/read (protocol v2 never
    writes, and the header stopped arriving anyway). Each was inferred from one
    bit of evidence - the frame landed or it did not.
    link_probe.ino replaces inference with measurement. It runs no frame protocol
    and never calls Serial.write(), and puts on the panel what Serial.available()
    actually returns, how many bytes actually arrived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
    [link_probe.ino]
2026-08-24 Render the dashboard on the MCU and send values, not pixels
    Pixel streaming cannot work on this board. Measured, not guessed: Serial on
    the UNO Q is Arduino_RouterBridge's Monitor, every available() is a mon/read
    RPC round trip costing ~595 ms, and link_probe.ino clocked 1.68 calls/second
    across a 247-second run - about 860 B/s. A 153,600-byte frame is a three
    minute transfer. That ceiling holds regardless of the separate bug where the
    router accepts data on TCP 7500 and delivers none of it.
    dashboard.ino draws the dashboard itself with Adafruit_GFX and consumes one
    newline-terminated record of about 76 bytes:
    FS|f=Hardware Field Test|s=HEALTHY|h=0.79|n=5|v=5|r=0|z=2|c=4|e=LIMITED|o=1
    U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
    [dashboard.ino, test_panel_values.py]
2026-08-24 Stop the dashboard flickering: repaint values, not the whole panel
    render() cleared the screen with fillScreen() and redrew everything once a
    second. There is no framebuffer between the sketch and the ST7789 - every draw
    lands on glass immediately - so a full clear-and-redraw is visible as the
    panel emptying and refilling, once per second.
    Split in two. renderChrome() draws the background, title, card shapes and
    fixed labels once at boot. renderValues() clears only each value's own few
    pixels before reprinting it, and is the only thing the loop calls.
    The score bar still clears its full track before drawing, because a shrinking
    score would otherwise leave the tail of the previous bar behin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
    [dashboard.ino]
2026-08-24 Fix the soil acquisition path, and stop blaming the wiring for code defects
    `DataSourceConfig.from_env()` raised NameError on every call. The `_resolve`
    helper added in c94a658 annotates its parameters with `Any`, but factory.py
    only imported `Optional`, and a nested function's annotations are evaluated
    when the enclosing function runs, not at import. That killed every acquisition
    path routed through the factory: live_collector, live_runner, and
    create_adapter's default config.
    The probe was never at fault. `jxbs_test.py` kept working throughout because
    it calls JXBSSoilAdapter.from_serial() directly and never touches the factory,
    which is what made this read as a hardware problem: standalo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
    [live_collector.py, test_live_collector.py]
2026-08-24 Name the unified sketch after its folder so arduino-cli can build it
    arduino-cli resolves a sketch by requiring the .ino to share its directory
    name, so hardware_test/fieldsense_unoq/sketch.ino would have failed to compile
    with 'main file missing from sketch'. The App Lab projects in this repo use
    sketch.ino and that is where the name came from, but the board builds with
    arduino-cli - the dashboard sketch next door is dashboard/dashboard.ino for
    exactly this reason.
    [fieldsense_unoq.ino]
2026-08-24 Instrument the GPS path so a silent receiver is distinguishable from a rejected one
    Serial1 is physically on the MCU, so Linux cannot watch it. A receiver that
    sends nothing and a receiver whose every sentence is being thrown away look
    identical from the host: both leave the cold-start NO_FIX constant untouched.
    Counters for bytes, complete lines, checksum passes and GGA sentences now ride
    on the NO_FIX payload, along with a sanitised echo of the last line seen.
    parse_gps_telemetry() short-circuits on parts[0], so trailing fields cost
    nothing and the host contract is unchanged - verified against the real parser.
    Reading: rx=0 is wiring, power, or a second driver on D0. rx>0 with lines=0 is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
    [fieldsense_unoq.ino]
2026-08-24 Quieten the GPS to what one drain can hold, and stop corrupting the Bridge
    The receiver was never silent. On-hardware counters: rx=275, lines=4, csum=0 -
    bytes arriving, sentences forming, every checksum failing, with digits missing
    from the middle of each one. Characters were being dropped, not garbled, so
    the baud was right all along.
    The cause is this sketch. Serial.available() on the Monitor transport costs
    ~595 ms, so loop() drains Serial1 roughly 1.7 times a second. A stock NEO-M8N
    talks GGA, GLL, GSA, GSV, RMC and VTG - about 960 bytes a second - and the
    receive buffer is a few dozen bytes. It cannot bridge that gap. I wrote in
    this file that sentences would drop 'while a frame strea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
    [fieldsense_unoq.ino]
2026-08-24 Drain the GPS UART on its own clock, not the Monitor's
    The receiver is fine: the last captured line was the tail of a GGA reporting
    DGPS quality 2, nine satellites and HDOP 0.89. Quietening it to GGA-only
    worked. What still failed was this loop.
    One serviceGPS() per pass is not enough when a pass costs ~595 ms in
    Serial.available(). Measured: rx=1518, lines=2 - bytes arriving, almost no
    newlines surviving. Sentences merged into each other, overran the 120-byte
    line buffer, and the surviving fragment could never checksum.
    Serial1 is now polled every 2 ms for a 400 ms window before the loop pays for
    one Monitor read. Two bytes can arrive between polls at 9600 baud, so the
    receive buffer neve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
    [fieldsense_unoq.ino]
2026-08-24 Fix --display bridge to send compact panel value records directly over TCP
    [test_panel_values.py]
2026-08-24 Fix test churn by ensuring test outputs use temporary directories
    [demo.py, test_run_spatial_test.py, test_standalone_deployment.py]
2026-08-24 Add the field run procedure, with the two GPS gates
    The collection sequence has lived in chat and in one person's head, and the
    hardware now sits with a teammate on a different machine. Written down here it
    travels with the repo, which is the one channel that already reaches the board.
    Structured around two gates, a distinction the hardware forced on us. Parser
    health and satellite lock are independent: whether NMEA sentences arrive and
    pass their checksums is verifiable indoors in seconds, while a fix needs sky and
    minutes. Conflating them sent someone outside to debug a firmware problem.
    Leads with what counts as done, because the failure that already bit us is
    silent - the collector run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
2026-08-24 Separate valid acquisition from a spatial demonstration in the field run
    The runbook required a different latitude and longitude on every sample, which
    conflated two different things. Non-zero coordinates are the acquisition
    requirement: they say the receiver had a fix and the sample is real. Distinct
    locations are a demonstration requirement: they are what gives the
    interpolation something to work with. Five readings from one spot are perfectly
    good sensor data and should not read as a failed run, which the old wording
    implied.
    Also refreshes the closing note, which claimed the step 1 firmware fix was
    unconfirmed on hardware. It ran clean on 2026-08-24: gate A passed, gate B
    reported FIX_O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
2026-08-24 Draw the dashboard before bringing up the link, not after
    setup() called tft.init(), then Bridge.begin() and Monitor.begin(), and only
    then drew anything. tft.init() wakes the panel and lights the backlight but
    leaves display RAM uninitialised - a blank white screen. Both begin() calls
    talk to the router over the RPC path measured at ~595 ms per call, which can
    stall or wedge, and anything drawn after them never gets drawn at all. The
    only symptom is a white panel that reports nothing.
    frame_receiver.ino already ordered this correctly, with a comment saying why;
    dashboard.ino regressed it. The chrome and values now paint first, so the
    panel always shows a dashboard reading "waiting for data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
    [dashboard.ino]
2026-08-24 Pin the FS| record against the firmware that parses it
    test_panel_values.py checks the record the host builds. Nothing checked it
    against the sketch that reads it - the contract existed only as a comment, and
    that comment named dashboard.ino while field runs actually flash
    hardware_test/fieldsense_unoq/fieldsense_unoq.ino.
    The far side of this format is firmware, so a mismatch is invisible until
    someone flashes a board and watches the panel not update. On the UNO Q that
    cycle is about ninety seconds. These tests read applyPair(), the FS| sentinel
    and the lineBuf size straight out of the .ino, so drift fails in CI instead:
    keys the firmware ignores, keys it expects but never receives, and th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
    [test_panel_record_contract.py]
2026-08-24 Add the SLM validation procedure, gated on what actually generated the text
    The claim to establish is narrow: a language model executed on the UNO Q and
    produced the narrative. Passing tests do not show that, and neither does a
    narrative appearing - the system is built to degrade quietly, and every
    dashboard so far has been badged MOCK_TEMPLATE_v1 without anyone noticing.
    So each gate is checked with tools/slm_probe.py, which ignores status lines and
    reports generated_by. A GGUF filename there is the proof; MOCK_TEMPLATE_v1 means
    templates, whatever else the run printed.
    Ordered so the cheap checks come first: what is already installed, then the long
    llama.cpp build, then weights, then two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
2026-08-24 Repaint dashboard values, not the whole panel, to stop the black wipe
    render() cleared the panel with fillScreen() and redrew every element once a
    second. There is no framebuffer between this sketch and the ST7789 - each draw
    lands on glass immediately - so the clear was visible: 153,600 bytes at the
    library default 24 MHz is ~51 ms of blank panel, then the elements reappearing
    one at a time. On hardware that reads as a black wipe sweeping the dashboard
    once per second, which is what was observed after the white-screen regression
    was cleared.
    The defect was not a regression. It has been in this firmware unchanged since
    the V1 run; the white screen hid it, and the "updated Ns ago" counter fo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
2026-08-24 Hold the panel socket open so a one-shot push actually lands
    python3 tools/push_panel.py reported success and left the panel showing
    dashes. --watch worked, which pointed at connection lifetime rather than the
    record.
    The MCU pulls; it is never pushed to. In monitor.h the only thing that fetches
    bytes from arduino-router is _read(), which opens with `if (!*this) return;` -
    a mon/connected check - so a record is collected only while a client is still
    connected. fieldsense_unoq.ino polls roughly once a second: GPS_DRAIN_MS is
    400 ms of draining the GPS UART, then ~595 ms for a single Serial.available()
    on the RPC transport. Connect-write-close finished in single-digit
    milliseconds, so the sen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
2026-08-24 Close the same panel timing race in the pipeline sender
    Fixing tools/push_panel.py did not fix `run_spatial_test.py --display bridge`.
    push_record_to_mcu opens its own socket and closed it straight after the write,
    so a full pipeline run reported PUSHED and left the panel on dashes for exactly
    the reason the one-shot command did.
    The MCU pulls; it is never pushed to. monitor.h's _read() opens with
    `if (!*this) return;` - a mon/connected check - so bytes are fetched only while
    a client is still connected, and fieldsense_unoq.ino polls about once a second
    (400 ms draining the GPS UART, then ~595 ms for one Serial.available() on the
    RPC transport). A connect-write-close takes single-digit mill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
    [test_panel_values.py]
2026-08-24 Separate TFT transport verification from field-data verification
    The panel path was verified on hardware on 2026-08-24, but the run that
    verified it read field_test_20260823_171931.json - which self-reports
    PROVENANCE: UNSTAMPED and MOCK_TEMPLATE_v1 [FALLBACK_TEMPLATE], on a synthetic
    ~20 m grid. The values on the glass prove the wire, the parser and the
    renderer. They are not field measurements and must not be shown as hardware
    evidence.
    New section 6a states the three claims separately, because collapsing them
    would overstate what the hardware has shown: the end-to-end pipeline is
    VERIFIED, the same path against LIVE_HARDWARE data is NOT YET VERIFIED, and
    multi-location spatial mapping is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
2026-08-24 Give the SLM runbook a disk check and a real download command
    The procedure said 'download the GGUF from Hugging Face' and left the how to
    the reader, and checked RAM but never disk. Both matter before a 0.40 GB pull
    onto a board whose home filesystem also has to hold a llama.cpp build tree.
    The curl invocation carries --fail deliberately. Without it curl writes an HTML
    error page to the .gguf filename on a 404, and the failure then surfaces as a
    magic-byte mismatch - which reads as a corrupt model rather than a wrong URL.
2026-08-24 Record the measured memory budget on the UNO Q
    The sizing table was built on an assumed budget with PENDING_HARDWARE against
    it. Gate 0 on the board reports 2.8 GB available with the GPS gateway running,
    which settles one recommendation: Phi-3-mini at 2.3 GB has 1.2x headroom, sits
    on the probe's WARN threshold, and would page - so the throughput figure in the
    table is optimistic for it. Qwen2.5-0.5B has 7x and stays the right first model.
    Tokens/sec is still unmeasured and still marked as such.
2026-08-24 Use the single-turn flag the target binary actually accepts
    llama.cpp on the UNO Q reports 0.2.0-dev, build 10615, commit f280b2698,
    aarch64. Its help offers -st, --single-turn and has no -no-cnv, which is what
    extra_args had been defaulting to. Verified on the board before any model was
    downloaded, which is the only reason it was found cheaply.
    The long form is used because a configuration value is read far more often than
    it is typed.
    This flag is not cosmetic. Without conversation mode suppressed, llama-cli waits
    for interactive turns, a subprocess with no tty returns nothing, the adapter
    records GENERATION_FAILED and falls back to templates - and the run still
    reports a complete narrat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
2026-08-24 Separate model execution from output acceptance in the probe
    The probe reported 'real model inference: NO' for a run where Qwen demonstrably
    executed - generated_by named the GGUF, llama.cpp reported 8.2 tokens/sec - and
    the text was rejected downstream. That verdict hid the single most useful thing
    the run established, and would have sent someone back to reinstall a model that
    was working.
    They are different facts. generated_by carries the model filename whenever the
    LlamaCpp path was taken, and a process that failed to run records
    GENERATION_FAILED or TIMEOUT rather than a guard violation, so execution is
    distinguishable from acceptance. The probe now reports both and has a third
    verdict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
2026-08-24 Add a stream dump that reproduces FieldSense's own subprocess conditions
    A hand-run llama-cli in a terminal is a different experiment from what the
    adapter does. llama-cli checks for a tty and renders a chat UI when it finds
    one, so shell redirection can leave both captured files empty while the text
    still reaches the screen - which is exactly what a stream test on the board
    produced, and it does not establish which pipe carries generation.
    --dump-streams runs the command _build_command actually builds, through
    subprocess.run with pipes and no tty, and prints both streams with their
    lengths. It distinguishes the three cases that need different fixes: text on
    stdout means _run_binary is alre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
2026-08-24 Add a tty matrix, after stdin=DEVNULL failed to explain the board
    The stdin-inheritance theory was falsified on hardware: with the probe run
    under < /dev/null, llama-cli still rendered to the screen and both pipes still
    came back empty. So it is not consulting isatty(stdin); it opens /dev/tty
    directly, and no stream redirection reaches that.
    --tty-matrix runs the real command four ways - inherited, stdin=DEVNULL,
    start_new_session, and both - and reports which yields piped output, alongside
    the probe's own tty context so a row that cannot reproduce the interactive case
    says so rather than passing quietly.
    Against a stub that mimics the observed behaviour, run under a real pty: the
    first tw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
2026-08-24 Run llama-cli without a controlling terminal
    llama-cli opens /dev/tty directly and renders its chat UI there. With a terminal
    present it exits 0 having written nothing to stdout or stderr, so the adapter
    received an empty string and the guard correctly reported EMPTY_NARRATIVE - for
    text the model had generated perfectly well, at 9.4 tokens/sec.
    Two theories were wrong before this one. Reading stderr would have changed
    nothing: stderr was empty too. stdin=DEVNULL changed nothing either, because
    stdin is not what llama-cli consults. Both were falsified by running the real
    command on the board rather than by argument.
    Measured on the UNO Q against llama.cpp 0.2.0-dev build 10615, same comman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
    [test_ai.py]
2026-08-24 Pin the llama.cpp furniture failure mode, before changing any behaviour
    Gate 2 on the UNO Q reported UNSUPPORTED_NUMBER[field_summary]:15.9 and :8.3.
    Those are not claims Qwen made about the field - they are llama.cpp's own prompt
    and generation token rates, reaching the guard through _clean_output. Attributed
    by running identical model text with and without the furniture: alone it draws
    no violations at all; with the spinner and timing line it draws exactly the pair
    observed on the board.
    So of the three violation types, UNSUPPORTED_NUMBER is entirely llama.cpp,
    LENGTH_EXCEEDED is substantially inflated by 470-1055 characters of furniture
    against a 900 and 500 character limit, and only FOR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
    [test_ai.py]
2026-08-24 Stop the prompt priming the claims it forbids, and give it a length
    Two findings from gate 2 on the UNO Q, both in the prompt rather than the guard.
    The rules said 'Never mention carbon credits, carbon offsets, or carbon
    sequestration'. Qwen2.5-0.5B produced all three phrases verbatim, in both
    sections, on every attempt including the retry. A 0.5B model reads an enumerated
    term as a topic, not a prohibition. The replacement is a positive scope rule -
    write only about the values in DATA, introduce no other subject - which covers
    those claims without writing the words, and covers whatever the next model
    drifts toward as well.
    The prompt also never stated a length. It asked for 'three or four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
    [test_ai.py]
2026-08-24 Explain the violations a run actually produced, not a fixed one
    The probe's closing note described EMPTY_NARRATIVE unconditionally, so a run
    rejected for length and forbidden claims was still told 'the adapter received no
    text' - advice about a failure mode that had already been fixed, on a run where
    the model plainly produced text.
    It now reads the violation codes and explains those, and says so plainly when
    there are none.
2026-08-25 Drop the chat banner and the echoed prompt before judging the model
    Gate 2 reported OK with llama.cpp's ASCII logo as the field summary. The guard
    had no reason to refuse it: not empty, no forbidden claim, and once the new
    sentence trim had shortened it, inside the character limit. A visible rejection
    had become a silent acceptance, which is worse.
    Captured from the board: this build prints a whole chat session on stdout - logo,
    a build/model/ftype block, a command menu, the prompt echoed after a > marker and
    elided as ... (truncated) when long, then the answer, then timings. Two rounds of
    blacklisting furniture had already missed pieces of it.
    So this stops guessing at the noise and uses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
    [test_ai.py]
2026-08-25 Reject generated text that contradicts the numbers it describes
    A physical run on the UNO Q reported OK with zero guard blocks for a narrative
    that got four things wrong: a POOR field called good, five samples rejected
    against a context of zero, a moisture deficiency described as high moisture, and
    LOW spatial support called high. The narrative was safe, in length, and used no
    number absent from the context. It was simply untrue.
    The guard could not have caught it and should not try. Its strongest rule is
    that every number appears in the context, and five does - as valid_samples.
    Binding a number to the field it is attached to is a different question, so this
    is a separate layer rather than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
    [test_fidelity.py]
2026-08-25 Count sections instead of calling any model text a clean pass
    Gate 3 on the UNO Q rejected field_summary for three contradictions and accepted
    ZONE-01, and the probe reported 'output accepted: yes' with a verdict of real
    inference confirmed. is_ai_generated is true when ANY section came from the
    model, so one accepted section made a half-template run look clean - the same
    conflation that once reported a rejected run as passing.
    Sections are now compared against what the deterministic backend would have
    written for the same context: an exact match means the model was rejected and
    this is the fallback. The probe reports the ratio, names which sections fell
    back, and has a distinct verdict for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
2026-08-25 Add autonomous field-node launcher and boot service
    The existing boot units push the panel through a Linux framebuffer. On the
    UNO Q that path cannot work: the QRB2210 routes no SPI to the external
    headers, so no /dev/fbN exists for this panel and an unattended boot leaves
    the screen dark. Nothing in scripts/ or deploy/ referenced v1_runner or
    --display bridge, which is the only transport that reaches the panel here.
    scripts/run_standalone_node.sh runs the whole loop from the board with no
    SSH: restarts the App Lab app when the gateway is unreachable, discovers the
    container address (it changes on every rebuild), waits for a satellite fix,
    then collects, interpolates, renders and pushes ove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
    [test_standalone_node_script.py]
2026-08-25 Record the measured Qwen vs TinyLlama comparison
    The sizing table carried bandwidth-bound estimates. There are now measurements
    from the board, five repeats each on the field_summary task that Qwen fails,
    using the shipped prompt, guard and fidelity checker.
    TinyLlama-1.1B is worse, not better: same 0/5 acceptance, 2.7x the generation
    time, 1.3x the resident memory. Qwen at least writes prose and gets two facts
    wrong. TinyLlama does not write a summary - it echoes the DATA block as a
    key-value list, quotes the TASK instruction including its own word budget, and
    is cut off mid-sentence.
    Both are deterministic across five runs, so neither result is a sampling
    accident. Recorded because a lar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
2026-08-25 Bind a sample count to its label, not to the number beside it
    The TinyLlama comparison exposed a false positive. Its answer ignored the
    instruction to write sentences and echoed the DATA block back as a list:
    'Sampled: 5 Sampled: 5 Rejected as Implusable: 0'. That rejected count is
    correct, and the checker called it a contradiction, because the pattern was
    written for prose - 'five were rejected', count first - and matched the 5 from
    the preceding field.
    Prose and lists put the count on opposite sides of the keyword. The labelled
    form is now checked first and wins, because a colon binds a value to its label
    in a way adjacency does not. Prose is still read when no label is present, so
    Qwen's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
    [test_fidelity.py]
2026-08-25 Find the model that is installed, not the one the default names
    Both AI asset defaults are deliberately generic: `llama-cli` on PATH and
    `models/fieldsense-slm.gguf` under the working directory. A library must not
    assume one machine's layout, and on a packaged install PATH is the right answer.
    On the UNO Q both miss at once. llama.cpp is built in-tree, so the binary is at
    ~/llama.cpp/build/bin/llama-cli and never on PATH, and the weights keep their
    upstream filenames rather than being renamed. is_available() returned False,
    AUTO resolved to the template backend, and the pipeline still printed SUCCESS
    with MOCK_TEMPLATE_v1 [FALLBACK_TEMPLATE] and `guard blocks: 0`. A fully green
    run containe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
    [test_standalone_deployment.py]
2026-08-25 Let the node wait for App Lab instead of reflashing over it
    Starting an App Lab app flashes the MCU: its log carries openocd bank writes and
    `Progress[sketch updated]`. The standalone unit was ordered only After=docker,
    so on a cold boot it could start first, find no GPS gateway, and call
    `arduino-app-cli app restart` while App Lab was still mid-flash. Two openocd
    sessions on the same SWD lines fail with `Error requesting gpio line swdio`,
    which needs `sudo killall -9 openocd` to clear - impossible on an unattended
    field node.
    The unit is now ordered after arduino-app-cli.service and arduino-router.service,
    and the node waits GATEWAY_WAIT_SECONDS (180) for the gateway before it will
    conside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
    [test_standalone_node_script.py]
2026-08-25 Version-control the App Lab profile the panel is actually built from
    The board's App Lab app is what flashes the MCU on every start, so its build
    profile decides which driver the panel is built against - and that profile lived
    only in ~/ArduinoApps/unified_v1/sketch/, outside this repository. The pinning
    decision behind a working panel was one SD card away from being lost, and
    nothing in the tree recorded that it had been made.
    The versions are pinned rather than left floating because App Lab's own library
    cache shipped ST7789 1.11.0 while the firmware verified on the glass was built
    against 1.10.4. Both compile. A drift there is invisible until someone looks at
    the panel, which is the wors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
    [test_standalone_node_script.py]
2026-08-25 Turn the five-point loop into a field session an operator drives
    V1 collected five points in a `for` loop. The counter lived in one Python
    frame, so nothing on the device could say which sample was in progress,
    nothing told the operator that sample 3 was stored, and a power cut lost the
    whole session. This makes the sequence explicit, durable, and readable off
    the glass.
    THE WORKFLOW
    fieldsense/field/ is hardware-free by design, so the part most likely to be
    wrong and hardest to debug standing in a field is testable at a desk:
    states.py BOOT/READY/MEASURING/SAMPLE_SAVED/READY_NEXT_SAMPLE/
    PROCESSING/RESULT/ERROR, as a transition table. An illegal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
    [dashboard.ino, field_node.py, fieldsense_unoq.ino]
2026-08-25 Never stamp COMPLETED on a session that holds no samples
    Observed on the board: a session manifest closed as COMPLETED with
    stored_samples = 0. The count was truthful - it is recomputed from disk on
    every write, and a concurrent process had removed the session directory after
    those samples were written. The status word was not.
    That combination is unreachable through the workflow: process() refuses to
    finish a session with fewer than three usable samples, so a manifest carrying
    it means the samples went missing after the fact - a deleted directory, a full
    filesystem, a half-restored backup. Reporting COMPLETED there is the one thing
    this store exists to prevent, because a manifest that read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
    [test_field_workflow.py]
2026-08-25 Put the touch controller on the pins this board actually reads
    The XPT2046 was rewired and reported as T_CS=D5, T_DO=D4, T_IRQ=D2 with clock
    and data shared with the display. Two things in that are wrong for this board,
    and the device tree settles both.
    ON THE UNO Q, HARDWARE SPI IS ON THE ANALOG HEADER, NOT D11-D13.
    arduino_spi is spi2: SCK = A5 (PB13), MISO = A4 (PB14), MOSI = A3 (PB15). The
    variant header's `#define MOSI/MISO/SCK 0` are stubs marked "TODO: correctly
    handle these legacy defines" - they are not pin numbers, which is why the
    sketches #undef them, and why nobody could have read the real mapping off them.
    So T_DO cannot live on D4. The SPI peripheral samples MISO from PB14 a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
    [dashboard.ino, fieldsense_unoq.ino]
2026-08-25 Give the display back its bus, and the SITES label its last letter
    TOUCH POLLING WAS WHITENING THE PANEL.
    With touch enabled, readTouchZ() ran on every pass of the 2 ms drain loop and
    opened an SPI transaction at 2 MHz on the same bus the ST7789 drives at 24 MHz -
    hundreds of controller reconfigurations a second, between display writes. The
    panel went white the moment that firmware met a wired touch controller.
    I had talked myself out of this theory on the grounds that both run sequentially
    in one loop() and so cannot collide mid-draw. The hardware disagreed: flashing
    this firmware with the touch jumpers STILL CONNECTED brought the display
    straight back, which isolates the cause to the pol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
    [dashboard.ino, fieldsense_unoq.ino]
2026-08-25 Stop telling the operator to press a key this board does not have
    The device has been logging "board VOL+/VOL- keys" and printing "USE VOL KEYS"
    on the glass. The UNO Q has no volume keys. It has one user push-button and a
    power button.
    "Volume Up"/"Volume Down" and the codes KEY_VOLUMEUP/KEY_VOLUMEDOWN come from
    the Qualcomm SoM's reference device tree, where those GPIO lines genuinely were
    a phone's volume rocker. I read the labels off the kernel, believed them, and
    wrote operator instructions from them - which sends someone into a field hunting
    for a control that is not printed on the hardware. The control is the USER
    button; the labels are an artifact of the SoM lineage.
    Nothing about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
2026-08-25 Catch the probe that lost contact, and count what was stored
    Three fixes from the first real field session, all of them things that session
    showed and no test could have.
    SAMPLE 6/5 ON THE RESULT SCREEN. sample_index is the NEXT sample to take, which
    is the right number in every state but the two after collection ends - by then
    it has advanced past the last stored point. A finished five-sample session
    rendered "SAMPLE 6/5" on the glass, which reads as a counting bug in the one
    place an operator is reading a total. PROCESSING and RESULT now show samples
    stored. Host-side only; the firmware just renders the numbers it is sent.
    A PROBE THAT LOST CONTACT WAS STORED AS VALID, FIVE TIMES.
    i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
    [test_field_workflow.py]
2026-08-25 Make the offline test something you can come back from
    The radios-off verification is a one-way door on this board. `nmcli radio wifi
    off` persists across reboots and the UNO Q exposes no serial console, so turning
    the radios off and hitting any problem leaves no way back in short of physically
    re-provisioning the board. That is a bad property for a test whose whole purpose
    is to be run unattended.
    Adds a one-shot unit that re-enables Wi-Fi 15 minutes after boot, so the offline
    window is real but bounded - long enough to watch the panel reach READY and take
    a few samples, short enough that a failed boot is not a lockout.
    It is a TEST AID and says so in its Description, its header, and the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
2026-08-26 chore: repair dead documentation links and tighten .gitignore
    48 links in the hardware records and the archived master audit pointed at
    `file:///C:/Users/lovsh/Desktop/FieldSense/...`. They resolved on exactly
    one laptop and were dead for everyone else, including for the person who
    wrote them once they changed machines. All 48 are now repository-relative
    and verified to resolve. Two of them named `test_q.py` and `test_q.ino`,
    which were renamed to `main.py` and `sketch.ino` some time ago -- those
    now point at, and are labelled with, the files that exist.
    The one remaining `file:///C:` string is in `DOCUMENTATION_AUDIT.md`,
    where it is the audit *reporting* this problem. Rewriting it would e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
    [dashboard.ino]
2026-08-26 docs: rewrite README as a project landing page
    The old README opened with a wall of pinout tables and never answered the
    question a judge, an evaluator or a farmer actually arrives with. It also
    carried numbers that had drifted: a "294 tests" badge, "529 should pass"
    in the body, and a status table listing touch and the display as pending
    hardware months after both were working.
    Restructured around what a reader needs, in the order they need it:
    What it does -> The device -> How it works -> Field workflow ->
    Offline operation -> AI safety -> The interface -> Hardware ->
    Quick start -> Repository structure -> Validation status -> Docs
    Three sections are new because they are product f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
2026-08-26 feat(hardware): implement IRQ-gated touch driver and clear operator retry prompts
2026-08-26 Drive the field workflow from the glass, on the half of the touch panel that works
    The operator can now run a whole sampling session from the TFT: start a sample,
    retry one the probe fluffed, advance to the next, and begin a new run. No
    laptop, no SSH, no Arduino tooling, no board button required.
    WHAT THE HARDWARE ACTUALLY IS, MEASURED RATHER THAN ASSUMED
    The XPT2046 on this panel is half-connected, and the two halves needed
    separating before any of this made sense:
    PENIRQ works. It needs only VCC, GND and the glass, and it tracked a finger
    perfectly - IQ toggled 1->0->1 under touch, IL latched.
    SPI does not. Z1/Z2 read zero even when the read was issued while PENIRQ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
    [fieldsense_unoq.ino]
2026-08-26 Let a failed run stay on screen, and stop inventing a touch coordinate
    Both found by running a full five-sample session from the glass with the probe
    in air - neither was reachable from the test suite.
    A SESSION THAT COULD NOT BE PROCESSED VANISHED OFF THE PANEL.
    The result hold covered only RESULT. A run that ends "0 of 5 samples are usable
    for a map" goes to ERROR instead, so it fell straight through, and --loop
    replaced the conclusion with READY within seconds. The operator saw a run end
    and never learned why - which is precisely backwards, because a failed walk's
    screen carries something a successful one's does not: the reason it failed.
    A session that could not be processed is as fin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
    [field_node.py, fieldsense_unoq.ino, test_field_node.py]
2026-08-26 docs: bring the README's field workflow up to the shipped touch behaviour
    The touchscreen work landed after the README was written, and it changed
    facts the README asserts. Three of them were wrong on the page:
    **"press the green bar on the glass"** described a control this unit does
    not have. `PENIRQ` on the XPT2046 works -- it tracks a finger, and `IL`
    latches -- but the SPI side does not: `Z1`/`Z2` read zero even when the
    read is issued while `PENIRQ` is low, which puts the fault on
    `T_CS`/`T_CLK`/`T_DIN`/`T_DO` rather than in the firmware. No coordinates
    means no hit zones, so the sketch accepts a contact anywhere when SPI is
    silent and narrows to the bottom bar only once a non-zero rea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
2026-08-26 ci: run the suite on every change, and hold the docs to its count
    No CI existed, so nothing verified the claim on the landing page. The
    test-count badge has now said 294, 529, 552 and 565, each correct when
    written and wrong within days, and each corrected only because a human
    happened to notice. A number a reader cannot check is a small lie sitting
    directly above an honest validation table, which is the worst place for
    one.
    Two jobs.
    **pytest** runs on push to main and on every pull request, against Python
    3.10 and 3.13. 3.10 is the floor `pyproject.toml` claims; if the floor
    ever breaks that is a packaging bug worth failing on here rather than
    discovering on a board. There is nothing to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
2026-08-26 Make the panel readable at arm's length in a field
    A visual-first pass over the TFT: traffic-light colour, a step bar, big
    counters, a zone map, and one full-width control. Rendering only - no Modbus,
    GPS, IDW, Qwen or storage behaviour is touched.
    THE TEASER AND THE BUTTON ARE NOW SEPARATE FIELDS, AND THAT IS THE WHOLE TRICK.
    One string used to carry both the situation and the action -
    "PLACE PROBE - PRESS START" - which is 25 characters and therefore rendered at
    text size 2 at best. Split, each half is short enough for the size that suits
    it: the teaser names the cause, the button names the act, and the button gets
    size 3 across the full width of the bar.
    READY PLACE PROBE IN SOIL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
    [dashboard.ino, fieldsense_unoq.ino, test_field_workflow.py, test_landscape_panel.py]
2026-08-26 Report the GPS counters on every payload, not only after a line parses
    The counters existed. They were unreachable in the one case that needed
    them.
    `publishNoFix()` reports rx/lines/csum/gga/ovf, but it only runs once a
    newline-terminated line has COMPLETED. So when a receiver delivers
    nothing the host sees the cold-start default and no counters at all --
    and "GPS unpowered", "TX not wired", "wrong baud" and "MCU wedged" are
    indistinguishable. That is exactly backwards: the harder the fault, the
    less the payload says about it.
    This cost real time today. A board sat on NO_FIX for eight minutes with
    no way to tell whether a single byte had ever arrived on Serial1.
    Reported on every payload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
    [fieldsense_unoq.ino]
2026-08-26 fix: name the sketch directory what arduino-cli requires
    `arduino-cli` resolves a sketch by looking for `<dir>/<dir>.ino`. The
    directory was `firmware/unoq/` and the sketch `fieldsense_unoq.ino`, so
    the documented command did not work at all:
    $ arduino-cli compile --fqbn arduino:zephyr:unoq firmware/unoq
    Can't open sketch: main file missing from sketch:
    .../firmware/unoq/unoq.ino
    I introduced this. The restructure moved the sketch out of
    `hardware_test/fieldsense_unoq/` -- where the directory and the file DID
    agree -- and renamed the directory to `unoq/` while leaving the file
    alone. Both `firmware/README.md` and `docs/FIELD_RUN.md` then documented a
    command that cannot run.
    I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
    [dashboard.ino, fieldsense_unoq.ino, main.py, test_landscape_panel.py, test_panel_record_contract.py]
2026-08-26 Show the raw bytes, because a byte count cannot name a fault
    The counters got us to "bytes arrive, no line ever completes" and stopped
    there. That sentence has two causes needing opposite fixes -- real NMEA at
    the wrong framing is a baud or contention problem, noise on a floating pin
    is a wire that is not connected -- and no count distinguishes them.
    gpsLastLine cannot either: it is written only when a line COMPLETES, which
    is precisely what was not happening.
    So this publishes a 48-byte rolling window of the raw stream, filled in
    serviceGPS() BEFORE line assembly so it survives the overflow-discard path
    that was swallowing everything, plus `hi`: how many bytes ever arrived
    with bit 7 set.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
    [fieldsense_unoq.ino]
2026-08-26 Refuse a GPS fix that is older than the sample it would tag
    `latest_gps_csv` persists in the firmware until the next successful
    parseGGA. On a healthy link that is invisible. On a degraded one the
    newest payload carries a position from minutes ago, and the host had no
    way to tell: nothing on the wire said how old a fix was.
    That is the failure this project keeps designing against. A stale
    coordinate is not a missing one -- it is plausible, it is in the right
    country, and stapled to a fresh soil sample it mislocates that sample
    silently. Downstream, a wrong coordinate is indistinguishable from a
    right one. It is the same class as "air samples are not soil data" and
    "jitter is not movement",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
    [fieldsense_unoq.ino, test_hardware_adapters.py]
2026-08-26 docs: write up the Serial1 overrun with the numbers behind it
    The GPS receiver is healthy, the wiring is sound, and the MCU parses about
    one sentence in fifty. This records why, so the fix can be a decision
    rather than an experiment.
    ROOT CAUSE, from the board rather than from reasoning:
    CONFIG_ARDUINO_API_SERIAL_BUFFER_SIZE 64 (generated autoconf.h:122)
    a GGA sentence 74-82 bytes
    The RX ring is smaller than one sentence, so it cannot hold a whole one
    under any timing. And the ISR's overflow policy is drop-NEWEST --
    `ring_buf_put` then `break` in zephyrSerial.cpp -- so what gets discarded
    is the sentence's TAIL, which is exactly where the `*hh` checksum and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
2026-08-27 docs: correct the GPS analysis - the 64-byte buffer is not the regression
    I published a root-cause claim that does not survive its own timeline, and
    it is the kind of error that sends someone rebuilding a Zephyr core for
    nothing.
    The RX ring was 64 bytes on 2026-08-24, while the GPS worked well enough
    to produce field_test_live_hardware.json: five samples, fourteen seconds
    apart. 7024f3e was written specifically to live inside that buffer and it
    succeeded. A constant that was already there during the good run cannot be
    what broke. It is a standing constraint the system used to stay inside,
    and the document now says so in a banner rather than burying the
    correction.
    The mechanism in section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
2026-08-27 docs: record the A/B that identifies quietenGPS as the cause
    One variable, both directions, same module and firmware.
    quietened (GGA only) : 60.2 B/s, lines 0.00/s, csum 0.00/s, gga 0.00/s,
    ovf 0.30/s
    un-quietened : 217.6 B/s, lines 3.54/s, csum 3.02/s, gga 0.25/s,
    ovf 0.05/s, FIX_OK 60/60, age 0, 12 sats, DGPS
    The function written to protect the link is what breaks it. GGA-only is one
    78-byte burst in 81 ms then 919 ms of silence; the 64-byte ring cannot hold
    it, and a burst landing in the ~595 ms blind window loses its tail - checksum
    and CRLF. Un-quietened, seven sentence types make a near-continuous stream the
    400 ms drain c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
2026-08-27 Stop repainting a panel that has not changed, and turn it 180 degrees
    Three fixes to the display path. Nothing outside rendering is touched - GPS
    parsing, the workflow, storage, the AI layer and the boot service are all as
    they were.
    THE FLICKER WAS MINE, AND THE CLUE WAS WHICH ELEMENT DID NOT FLICKER.
    "FIELDSENSE stays stable while other content wipes" is precisely diagnostic:
    FIELDSENSE is drawn in renderChrome(), which runs once in setup(). Everything
    else is drawn in renderValues(), which runs every second so the link-age counter
    stays truthful.
    The original architecture had that split right. The visual-first pass collapsed
    it: renderSoilCard() opened with a fillRoundRect of the whole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
    [dashboard.ino, fieldsense_unoq.ino, test_landscape_panel.py]
2026-08-27 Ask for a deliberate hold before throwing a field result away
    Touch on this unit has no coordinates, and now we know why rather than suspect
    it. SPI loopback with A3 (SPI2_MOSI) jumpered straight to A4 (SPI2_MISO), the
    XPT2046 disconnected and its CS held high:
    TX: AA 55 -> RX: 00 00 194 runs, 0 matches
    SPI2 cannot receive on this board. Not wiring - the touch controller was not in
    the circuit. The device tree explains why four rounds of testing could not see
    it: spi2_miso_pb14 carries bias-pull-down, so an undriven MISO reads a clean
    0000, byte-identical to a dead RX path. Nothing in this project had ever needed
    SPI RX, because the ST7789 is write-only.
    So there is no hitbox,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
2026-09-04 Send the zone letters the panel already knew how to draw
    A finished field session showed NO ZONES on the glass however many zones
    the spatial engine had found. A live run on the board found one zone,
    wrote "zone_statuses": "G" into artifacts/panel_summary.json, and still
    drew NO ZONES.
    Every layer of the path already existed. run_spatial_test writes one
    status letter per zone, load_panel_summary returns the file unfiltered,
    PANEL_RECORD_FIELDS reserves record field `u` for the letters, the sketch
    parses `u` into zoneStatuses, and renderZoneGrid draws a tile per
    character. Only _result_overlay never forwarded the key -- it read
    panel_summary.json for the status, the score and the evidence le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
2026-09-06 Show the map first and write the prose afterwards
    A finished walk left the panel on PROCESSING - PLEASE WAIT for two
    minutes. Every deterministic result behind that screen - the IDW grid,
    the zones, the health score, the recommendations - was finished about a
    second after the last sample. The rest was the local SLM: 124,957 ms
    measured on the run that prompted this, and the fidelity guard rejected
    what it produced anyway (FALLBACK_TEMPLATE, two guard violations). Two
    minutes an operator stood in a field waiting for text that was thrown
    away.
    The narrative was inline in build_dashboard, so the HTML write,
    write_panel_summary, and the RESULT push all queued behind it.
    `with_narrative=False` s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
2026-09-06 Put the panel back the way up somebody actually saw it
    PANEL_ROTATION was changed from 1 to 3 in 97f85af, on the reasoning that
    3 is "the same landscape surface turned through 180 degrees, so the unit
    reads correctly in the orientation it is actually held".
    Nobody had held it. The board has run the rotation-1 sketch continuously
    since 9235002 - its sketch blob is still 6673ff14 today - so the 3 never
    reached the glass to be checked against a hand. When the panel was
    finally read in the intended orientation it was already upright, which
    makes 1 correct and 3 the same picture upside down. A flash carrying 3
    would have taken a display that was right and turned it over.
    What made this dangerou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
    [dashboard.ino, fieldsense_unoq.ino, test_landscape_panel.py]
2026-09-06 Give the finished run two more ways to be looked at
    The result screen says 73% HEALTHY and one zone. It cannot say WHERE,
    and the operator standing in the field is the one person who could act
    on that. This adds two pages behind the result: the interpolated grid,
    one tile per cell in the same G/A/R/? alphabet the zone tiles already
    use, and the walk itself - five dots, numbered, in order, inside the box
    the engine drew round them.
    NAVIGATION IS A SHORT PRESS, because it is the only gesture left. The
    touch controller pen-detects but does not answer over SPI, so there are
    no coordinates and therefore no tabs and no hit zones. The result screen
    already demanded a long hold to start a new run;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
    [dashboard.ino, field_node.py, fieldsense_unoq.ino, test_run_spatial_test.py]
2026-09-06 Write the flash procedure down before anybody needs it
    Reflashing blanks the panel for about ninety seconds and puts openocd on
    the SWD lines App Lab is already using. The recovery for that collision
    is 'sudo killall -9 openocd', which is not something anybody derives
    while standing over a dark panel.
    The order matters more than any single step: compile before flashing,
    stop the node before flashing, and check the orientation before
    believing anything else on the glass. The rollback names the exact blob
    the board ran for weeks, so putting it back is a hash comparison rather
    than a judgement call.
2026-09-06 Record the compile, and the way the board falls over under load
    The sketch builds: 125,092 bytes of program storage, 50,394 of globals,
    no errors, against arduino:zephyr:unoq on the board itself. That was the
    gate the whole procedure hung on.
    The board also went unreachable twice under sustained compile load -
    SSH timing out while ICMP still answered, then coming back a few minutes
    later with uptime reset, which is a reboot rather than a busy sshd. Both
    times followed heavy CPU work. That is worth more than the compile
    numbers: a board that reboots mid-flash is the one failure the rollback
    section cannot help with, so the procedure now says compile one sketch
    at a time and let the board set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
2026-09-06 Correct the load claim: the board was switched off, not falling over
    f835af4 said the board drops off the network under sustained compile
    load, twice. That was inference from two SSH timeouts, and it was wrong.
    Both were the operator switching the unit off - the second confirmed
    directly, the first never asked about. ICMP answering while SSH timed
    out is exactly what a unit mid-power-cycle looks like, and a reboot was
    read as a crash because a crash was the story already in my head.
    No evidence exists that this board is unstable under load. A warning
    that names a fault nobody has seen is worse than no warning: it sends
    the next person hunting a thermal or power problem that may not be
    there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
2026-09-06 The board was on a flat battery: flash on mains, never on battery
    Third version of this note, and the first with the actual cause. The
    unit browned out twice during compiles. I called it a hardware fault
    under load, then called it the operator switching it off. It was a
    depleted battery, which makes the load correlation real and the fault
    imaginary - a compile is precisely the sustained draw that finds a
    battery with nothing left.
    That matters more than either wrong version did, because it turns a
    vague 'keep it powered' into a hard precondition. A flash is the same
    current draw with none of the forgiveness: a brownout part-way through
    writing the MCU is unrecoverable, and on battery it is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
2026-09-06 Say where openocd actually is, so nobody installs a second one
    The recovery step tells you to killall -9 openocd, and 'command -v
    openocd' on this board returns nothing. That combination invites
    somebody mid-incident to conclude the toolchain is broken and start
    installing one, which is the last thing a board with SWD contention
    needs.
    It is at /opt/openocd/bin/openocd, just off PATH, and killall matches on
    process name so the instruction was always correct - only unverifiable
    in the obvious way.
2026-09-06 Put the touch line on an interrupt, because a poll cannot see it
    Fifteen presses registered on the MCU and not one turned a page. The
    presses were real - IL=1, TP=1, UI climbing - and every one of them was
    measured as longer than RESULT_HOLD_MS, so every one read as a new-run
    hold and none as a page turn.
    The cause is in loop(). serviceTouchIrq() is a bare digitalRead called
    every 2 ms, but only inside the 400 ms GPS drain window. The rest of the
    pass is one Serial.available() on the Monitor transport, which costs
    about 595 ms and blocks: nothing in loop() runs while it is in there.
    Touch was unobserved for roughly three fifths of every second.
    There is no line you can add another poll to.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
2026-09-07 Report what the touch actually measured, so we stop guessing
    Two fields on the telemetry line, nothing else touched.
    HD is how long the last completed contact lasted, timed by touchIsr()
    from the two PENIRQ edges. Without it, a press rejected for being under
    TOUCH_HOLD_MS and a press that was never seen at all are
    indistinguishable from the host: both leave UI unchanged and look
    identical on the wire.
    PG is the page index on the glass. A page turn is entirely MCU-local, so
    there is currently no evidence anywhere that a short press did anything.
    UI staying flat means "not a long hold" and nothing more - which is
    exactly the ambiguity that stalled the last test: flat UI was equally
    consisten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
    [fieldsense_unoq.ino]
2026-09-07 Set the rotation back to 3, and write down what actually flashes
    PANEL_ROTATION was changed to 1 in 9d8daf9 because the panel was read as
    upright and this repository said the board ran rotation 1. The second
    half was false. App Lab flashes its own copy of the sketch, at
    ~/ArduinoApps/unified_v1/sketch/sketch.ino, and that copy was 209ae8a -
    which sets 3. So the upright display somebody looked at was a rotation-3
    display, and 9d8daf9 pinned it upside down. It claimed to prevent
    exactly the harm it introduced.
    The rotation is the small part. The real defect is that
    docs/PHASE2_FLASH.md - written in this same effort - told you to flash
    with `arduino-app-cli app restart` and never mentioned tha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
    [dashboard.ino, fieldsense_unoq.ino, test_landscape_panel.py]
2026-09-07 Make the panel answer a finger the way a phone does
    Three changes, all of them things HD measurements argued for.
    THE HOLD FIRES WHILE THE FINGER IS DOWN. It used to wait for release,
    which is why a hold felt broken: the operator got no acknowledgement
    until after they had already given up. Now the bar under the button
    fills, and at HOLD_FIRE_MS the new run starts with the finger still on
    the glass. The fill IS the acknowledgement.
    THE TAP FLOOR DROPS FROM 180 ms TO 48. Measured, an ordinary session of
    taps came in at 58, 63, 73, 118, 178, 262, 427, 537 and 887 ms - so 180
    was discarding five taps in nine. Phantoms in the same session measured
    25, 25 and 42 ms, and the ISR already drops an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
    [fieldsense_unoq.ino]
2026-09-07 Stop throwing away the tap that came during the wind-down
    Between one sample and the next the panel was unresponsive for about
    eight seconds: two panel pushes at three seconds each plus a two-second
    dwell. And `sync()` at the top of the sample loop deliberately DISCARDS
    presses made while the device is busy - so an operator tapping NEXT SITE
    in that window had the press measured perfectly by the MCU and dropped
    by the host. From the outside that is indistinguishable from a dead
    panel, which is what it was reported as.
    Touch was never the problem here. The telemetry read MCUTrigger polls
    costs 1 ms, not the ~595 ms assumed: the gateway serves a cached line.
    Host detection is under half a sec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
    [field_node.py]
2026-09-07 Let the button say it felt the tap, without asking the host
    A tap fires on the MCU in about 50 ms. The screen it changes belongs to
    the host, and a host-driven repaint is up to one loop pass behind -
    measured at ~1035 ms, because Serial.available() alone costs ~595 ms. So
    the tap was being registered perfectly and acknowledged a second later,
    which is the gap between "responsive" and "did that work?".
    The button now takes its pressed shade the instant the press fires,
    locally, for 200 ms. COL_GOOD rather than a new colour: it is already
    this button's own border, so a press is the brighter of the two greens
    the theme uses here. Same interior rect and same label as the normal
    path, one shade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
2026-09-08 Stop letting the sky decide whether the probe read the soil
    session_20260907T073053Z read 7 of 7 registers on every one of five
    samples, with no read errors, and returned live varying soil: EC
    0.070-0.129, pH 6.24-6.43, N 5-9, P 7-12, K 14-25. The panel said 0 of 5
    usable. Somebody walked a field for nothing.
    measurement_quality was gps_factor x hdop_factor x satellite_factor x
    completeness. On three or four satellites satellite_factor is 0.75, so
    the ceiling was 0.92 x 1.00 x 0.75 x 1.00 = 0.69 against a 0.70
    threshold. Not "hard to pass" - arithmetically impossible. Every sample
    was decided before the probe went in, and the one number was answering a
    question about the sky while claiming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
    [test_field_workflow.py, test_standalone_deployment.py]
